arcadien/tars/hardware/design_notes.md

# TARS4 — design notes

Why each part is there and where it sits, plus the design rules behind the circuit. The circuit itself is the KiCad
schematic ([kicad/tars4.kicad_sch](kicad/tars4.kicad_sch), PDF [kicad/tars4_schematic.pdf](kicad/tars4_schematic.pdf)),
the boards are the plans generated by `tools/boards.py` (`renders/tars4_board_{s3,p1,p2,power}.svg`, checked against the
schematic), the GPIO assignment is the README's *Signals* table, the wiring is [tars4_wiring.html](tars4_wiring.html)
and the harness guide [tars4_harness.html](tars4_harness.html). Requirements: `requirements/`.

## Parts

| Ref | Part | Why / where |
|---|---|---|
| U1 | TP4056 + DW01 + FS8205A | 0.5 A charge: its R_PROG (1.2 k, "122") is replaced by 2.4 k ("242"); at 1 A it would dissipate 1–1.8 W in the closed leg. Cell protection. |
| BT1, BT2 | 18650, in parallel | same model, voltages equal within ±0.05 V before joining them; each cell comes through its XH connector (X12 left, X16 right), joined on the TP4056 B+ / B− pads |
| F1, F2 | PPTC 30 V, 1.6 A hold (~3.2 A trip), XF160 | on the + of each cell, right after the + plate; standing on the inner front wall in front of each cell (15 mm wide: too wide for the top shelf) |
| J1 | micro-USB breakout (`usbb` in the model) | the charge port, at the heel of the left leg; its VBUS / GND go to the TP4056 IN pads |
| D3 | TVS SMAJ5.0A / SMBJ5.0A, unidirectional | on the TP4056 IN+ / IN− pads, cathode on IN+: electrostatic discharges; does not protect against a lasting overvoltage |
| C9 | 22 µF 16 V electrolytic (10–47 µF), Ø ≤ 5.15 lying | with D3 on the TP4056 IN pads: damps the hot-plug overshoot at the end of the ~16 cm of wire from J1 |
| Q1 | AO3401A, logic-level P-MOSFET | power path: cells → VSYS, off on mains (gate on VUSB) |
| D1 | 1N5822, 3 A Schottky, through-hole | VUSB → VPATH on mains; band on the VPATH side, before the switch |
| R1 | 4.7 k | Q1 gate → GND: fast switch-over when unplugged (~50 ms); a warm D1 leaking 50 µA leaves the gate < 0.25 V |
| SW1 | slide switch, ≥ 1 A | after the merge point; rating to check (often only 0.3–0.5 A) |
| U9 | TPS63020 module, 3.3 V | buck-boost in the left leg, 3.3 V to the S3 3V3 pin; EN to VIN, PS/SYNC to GND (solder bridge, never high). Its own VSYS / GND pair from the star; the logic GND to P1 leaves from its GND pad, along its 3V3 wire |
| C1 | 220 µF 10 V polymer tantalum 7343 (Panasonic 10TPE220ML, ESR 25 mΩ), band = + | mandatory: 3V3 → GND as close as possible to the S3 3V pin, flat on the carrier under the S3, ~35 cm of wire from the TPS63020 |
| R15, R16 | 68 k + 100 k | on the power-path board: VUSB → USB_DET (GPIO21), ~3 V with the charger plugged in, 30 µA on USB only |
| R2, R3 | 1 M + 1 M | R2 in line in the harness at the TP4056 B+ pad (the sense wire carries B+ only behind 1 M), R3 on the power-path board: B+ / 2, the cell voltage even on mains (VSYS is then the USB rail, ~4.6 V); the VBAT/2 wire goes to GPIO1 (≈ 2 µA standing, C6 holds the reading) |
| Q4, R23, R24 | BC547B NPN + 1 M + 330 k (1/4 W) | VSYS sense (GPIO37, low = rail up, threshold 2.3–2.7 V, above the amplifier's 2.5 V minimum): R23 soldered in line in the harness at the power-path board end (the wire through the left tube only carries VSYS behind 1 M), then X14 → R24 base → GND and Q4 standing on the carrier, collector bridged to IO37 (internal pull-up only while reading), ~2–3 µA |
| C6 | 0.1 µF ceramic ("104"), never tantalum nor film | GPIO1 → GND at the S3: a tantalum's leakage would skew the reading by up to 0.5 V; film is too wide |
| C8 | 0.1 µF ceramic ("104") | GPIO21 → GND at the S3: USB_DET comes out of a ~40 k divider and runs along the amplifier pair in the left tube |
| C2, C3 | 10 µF 16 V tantalum (+ to 3V3) or X5R / X7R ceramic, + 0.1 µF ceramic | on P1, between the 3V3 and GND strips |
| R4 | 10 k | on P1, BL_EN → GND: backlights off at boot |
| R10 | 1 k | on P2, in series GPIO4 (AMP_SD) → amplifier SD |
| R18 | 10 k | on P2, amplifier SD → GND: the amplifier stays off at boot and in sleep despite its board's pull-up (SD < 0.16 V) |
| C7 | 470 µF 10 V low-ESR electrolytic, Panasonic EEUFC1A471, Ø8 × 11.5, − to GND | on the amplifier VIN / GND pins (module side of X5), lying behind the board |
| R11, R13, R14, R20 | 33 Ω | in series at the S3: microSD CLK, amplifier BCLK and LRC, screens MOSI |
| R12, R19 | 47 Ω (up to 100 Ω) | on the S3 carrier: split SCK, R12 → screen 1, R19 → screen 2 through its own wire |
| R5–R9 | 10 k | microSD pull-ups (CMD, D0–D3) to SD_3V3, if the reader has none |
| Q5, R22 | AO3401A + 100 k | on the power-path board: cuts the microSD 3V3 in sleep (GPIO36 SD_EN low = on; R22 gate → 3V3 keeps it off while the pin floats) |
| C4, C5 | 10 µF 16 V tantalum (+ to SD_3V3) + 0.1 µF ceramic | at the microSD reader (hot insertion) |
| R17 | 1 k | on P2, in series between the AM312 output and the PIR wire (GPIO3): limits the current if the pin is misconfigured |
| R21, C12 | 100 Ω + 10 µF 16 V tantalum (+ on PIR_VDD) | on P2 (fc 160 Hz, ~40 dB at 20 kHz): filters the AM312 supply against the backlight PWM ripple on the shared 3V3 |
| C10, C11 | 10 µF 16 V tantalum (+ to 3V3) + 0.1 µF ceramic | on P2, between the 3V3 and GND strips |
| U10 | AM312 PIR | top of the right middle column, dome flush in a Ø11.5 front hole (cap glued from the inside), 1.25 mm right of the axis to clear the middle tube; 2.7–12 V, ~15 µA, push-pull output held ~2 s, active high |
| U11 | BME280 (GY-BME280, 3.3 V) | right leg, the coolest spot, sensor against the wall facing a Ø1.5 vent; I2C 0x76 / 0x77; SDA / SCL / 3V3 / GND from P2 through the right tube |
| LS1 | speaker, 4–8 Ω | on OUT+ / OUT− (no ground); size not settled (branch `mech-audio`) |
| P1, P2 | stripboards 24 × 32 | distribution: P1 left middle under screen 1, P2 right middle under screen 2 |
| U2 socket | 2 female 2 × 8 headers on the 25.6 × 34.4 carrier (P3) | the S3 plugs in; all its wires are soldered on the back of the carrier |
| X1–X16 | keyed Dupont (X1–X9, X15), JST-XH (X10, X12, X13, X14, X16) | one connector between each module and the harness, nothing to re-solder to test or swap a module; list and keying in the wiring plan |
| (Q2, Q3) | AO3401A + AO3400A or 2N7002 + 10 k | probably not needed: BLK most likely drives an on-board transistor (a few mA). Only if the measurement shows BLK feeds the LEDs |

## Power and ground

- B− is not GND: the DW01 and its MOSFETs (FS8205A) sit between them. Everything else refers to OUT− (GND).
- Star ground on the power-path board (left leg): the TPS63020 and the amplifier each get their own VSYS / GND pair from
  it; the logic GND to P1 leaves from the TPS63020 GND pad and runs along its 3V3 wire (a single loop); the microSD
  gets its own GND from P1. Twisted pairs: B+ / B−, amplifier VSYS / GND, microSD CLK / GND.
- On mains, VUSB turns Q1 off (gate at 5 V) and feeds VSYS through D1 (≈ 4.7 V); the cells charge on their own. On
  battery, R1 pulls the gate to 0 V and Q1 conducts.
- Battery cut-off at 3.3 V read on B+ (GPIO1, under load): the TPS63020 holds 3.3 V down to ~2.5 V input, the cut-off
  only spares the cells.
- The S3 V pin (VBUS) only gets its own USB-C (its contact is removed from the carrier header): a PC's 5 V only feeds
  the S3 internal regulator (ME6211, 500 mA), never VSYS nor the cells. Flash with the switch on or off. On USB, the
  ME6211 and the TPS63020 feed the 3V3 together: the TPS63020 in power-save mode does not fight it. Never drive its
  PS/SYNC high: in forced PWM it can sink current and send the S3 regulator's current back to the cells. On battery, a
  little 3.3 V leaks back through the ME6211 to VBUS (to measure, cable plugged into a PC that is off).
- To check: the TPS63020 must not start from its output (VSYS < 2.5 V), the max input voltage of the unpowered MAX98357A.

## Signals

- BL_EN (GPIO7) only drives the backlights: PWM possible (LEDC, ~20 kHz). R4 holds it low at boot, `gpio_hold` in
  sleep. Not the S3 EN pad (that is its reset, next to GPIO1).
- AMP_SD (GPIO4): R10 in series and R18 to GND on P2, the amplifier stays off at boot and in sleep whatever is on BLK;
  high (> 1.4 V) = left channel. To check: the SD pull-up on the amplifier board (Adafruit: 1 M).
- Amplifier on I2S0 (BCLK, LRC, DIN), microphone on I2S1 with its own clocks (GPIO 14, 38, 15), wired locally: neither
  imposes a sample rate on the other.
- Screens: SPI at 26.7 MHz to start (35 ms per frame and screen), 40 MHz to try (ST7789 ~62 MHz max); SCK split on the
  carrier (R12 → screen 1, R19 → screen 2, its own wire), up to 100 Ω if the image jitters; screen 2's SCK next to its
  GND in the tube, away from BCLK; GPIO12 with reduced drive strength. Shared RST: `RST = -1` in the library, one reset.
- microSD: on a reader labelled for SPI, CLK = SCK, CMD = DI / MOSI, D0 = DO / MISO, D3 = CS (pull-up). SDMMC 1-bit
  10 MHz, R11 in series on CLK, C4 / C5 at the reader.
- I2C at 100 kHz with the glitch filter: ADXL345 0x53, BME280 0x76, DS3231 0x68 + its EEPROM 0x57. The boards'
  pull-ups add up (~1.6–2.4 k): fine at 100–400 kHz, remove one pair if needed. ADXL345: CS to 3V3 (I2C), SDO to GND.
- DS3231 ZS-042 with a CR2032: remove the cell charging resistor; SQW not wired (the S3 wakes on its own timer, the
  RTC keeps the time).
- Charger detection: USB_DET (GPIO21) high = cable in the charge port (display, no battery cut-off, wake on plug-in).
  End of charge is deduced from B+ (GPIO1) falling back from 4.2 to ~4.15 V while USB_DET stays high.

## Sleep and wake-up

- Wake-up: on the ESP32-S3, EXT1 takes one polarity only. Everything is active high: ADXL345 INT1, PIR (AM312) and
  USB_DET → EXT1 ANY_HIGH on GPIO 2, 3 and 21. Remove from the mask any source already high when going to sleep
  (GPIO21 on mains, GPIO3 while the PIR holds), otherwise the S3 wakes at once. Timed wake-up: the S3 timer. Clear the
  ADXL345 INT_SOURCE and wait for PIR low before sleeping.
- Aim at ~0.2–0.4 mA in sleep: remove the S3 RGB LED (GPIO47, 0.3–1 mA even off) and every status LED fed by the
  battery (ZS-042, TPS63020 module, GY-291, microSD reader), keep the TP4056 charge LEDs (USB only); disable the DS3231
  32 kHz output (register 0x0F bit 3); send SLPIN to the screens; `gpio_hold` on CS1 / CS2 / RST / BL_EN / AMP_SD; Q5
  cuts the microSD 3V3 (SD_EN high or floating).
- Deep discharge: after the 3.3 V cut-off ~5–10 % of capacity is left; the TPS63020 (25–50 µA), the R2 / R3 divider
  (2 µA), the SD card (0.1–0.5 mA), the RGB LED and above all the ZS-042 LED (1–3 mA) would drain it in 1–3 weeks.
  Store an "empty" flag in RTC memory (no wake-up until recharged).
- Firmware: ignore the cut-off if B+ < 2.5 V; keep BL_EN, AMP_SD and the amplifier I2S off until the supply is
  validated (VSYS sense on GPIO37, PLAT-POWER-VSENSE-001).
- Motion sensor uses: wake on approach, lock the PC (BLE keyboard) when leaving.
