arcadien/tars/references/51xlwRLxzuL._AC_SL1200_.jpg

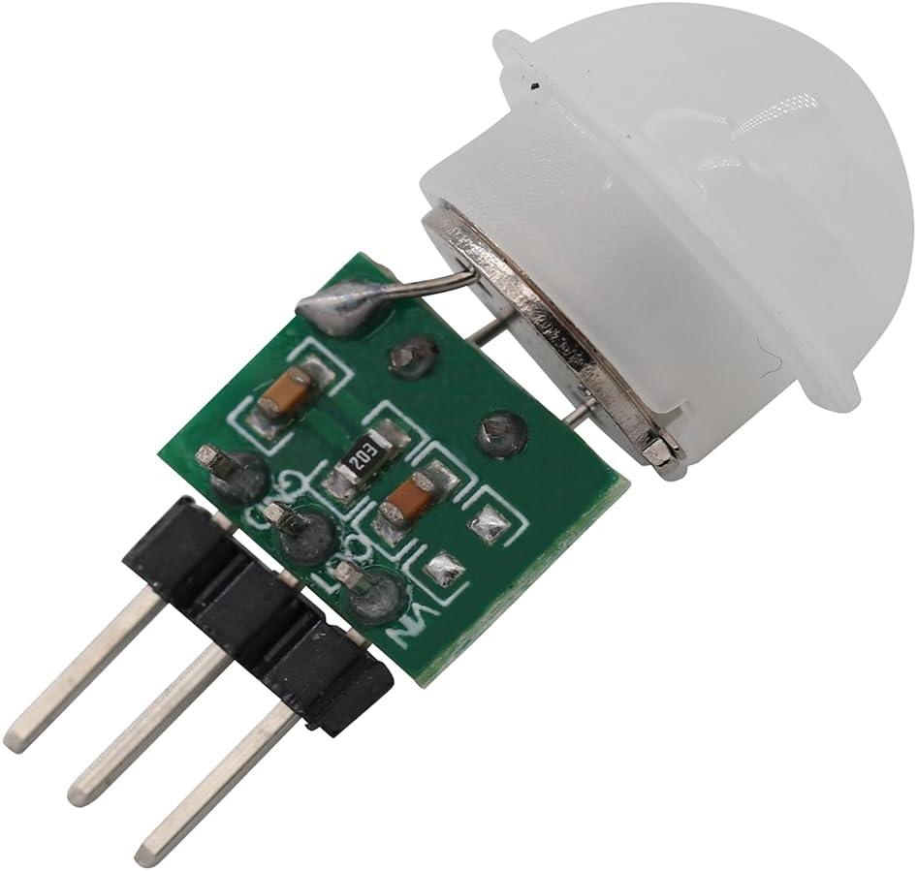
references/51xlwRLxzuL._AC_SL1200_.jpg
