arcadien/tars/references/ds3231_adxl345.jpg

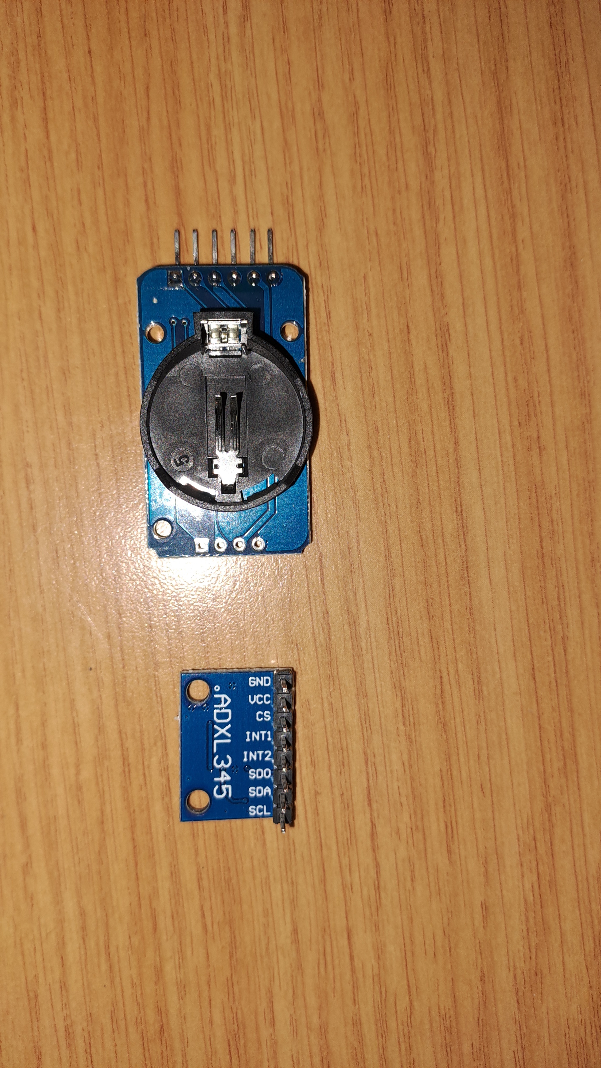
references/ds3231_adxl345.jpg
