arcadien/tars/references/esp32_s3_mini.png

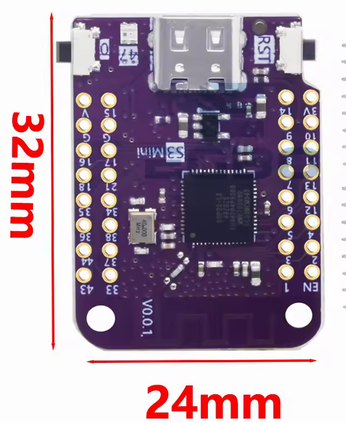
references/esp32_s3_mini.png
