arcadien/tars/references/film_still_tars.jpeg

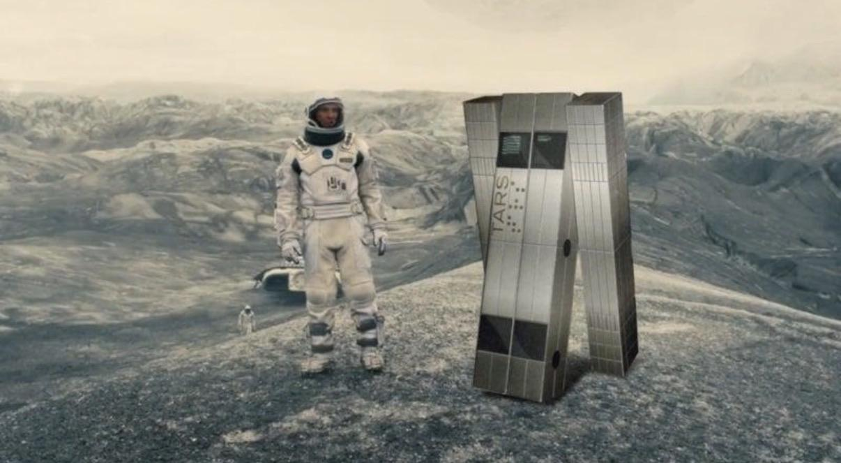
references/film_still_tars.jpeg
