arcadien/tars/references/film_still_torso_zoom.png

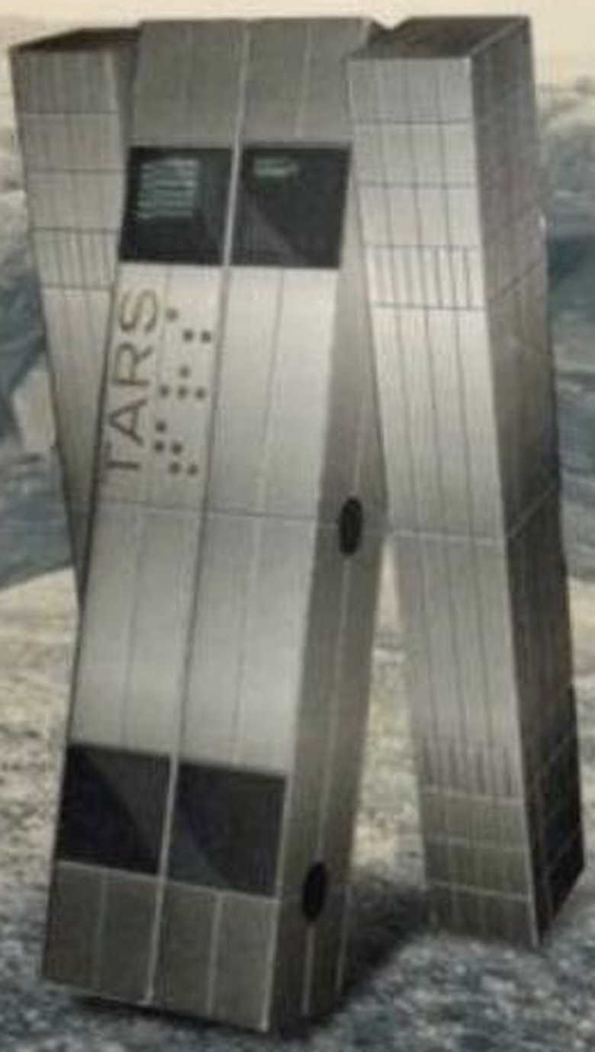
references/film_still_torso_zoom.png
