arcadien/tars/references/inmp441.png

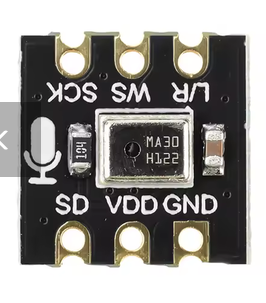
references/inmp441.png
