arcadien/tars/references/lcd_1.3_st7789_zjy-ips130.jpg

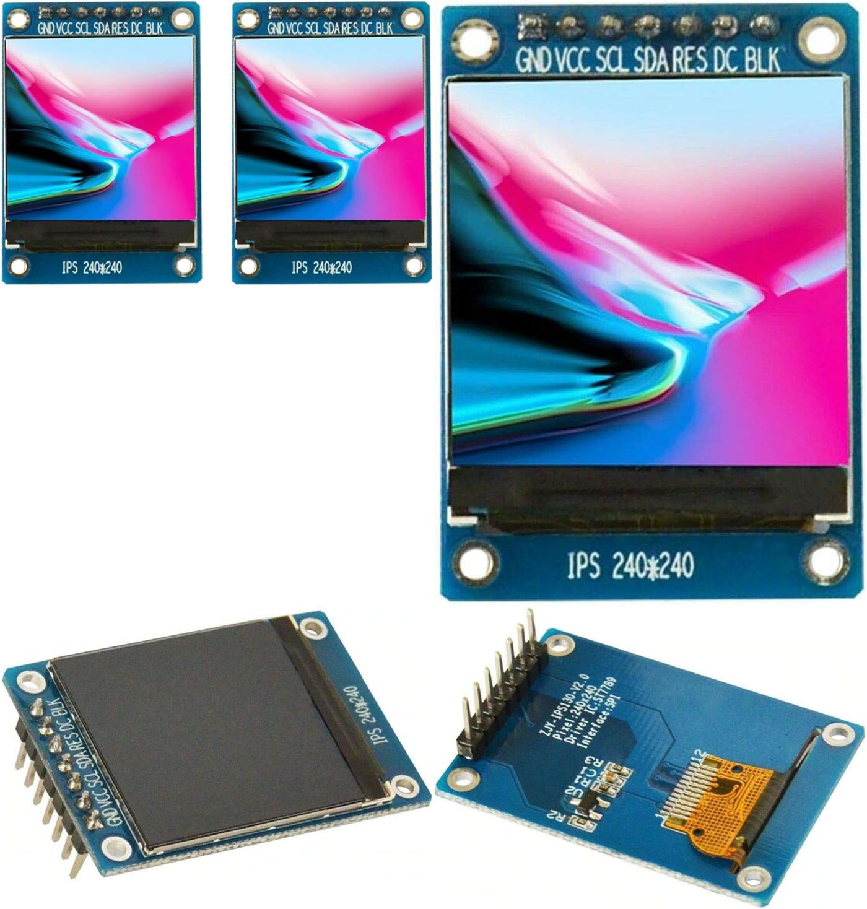
references/lcd_1.3_st7789_zjy-ips130.jpg
