arcadien/tars/references/s3_mini_dimensions.png

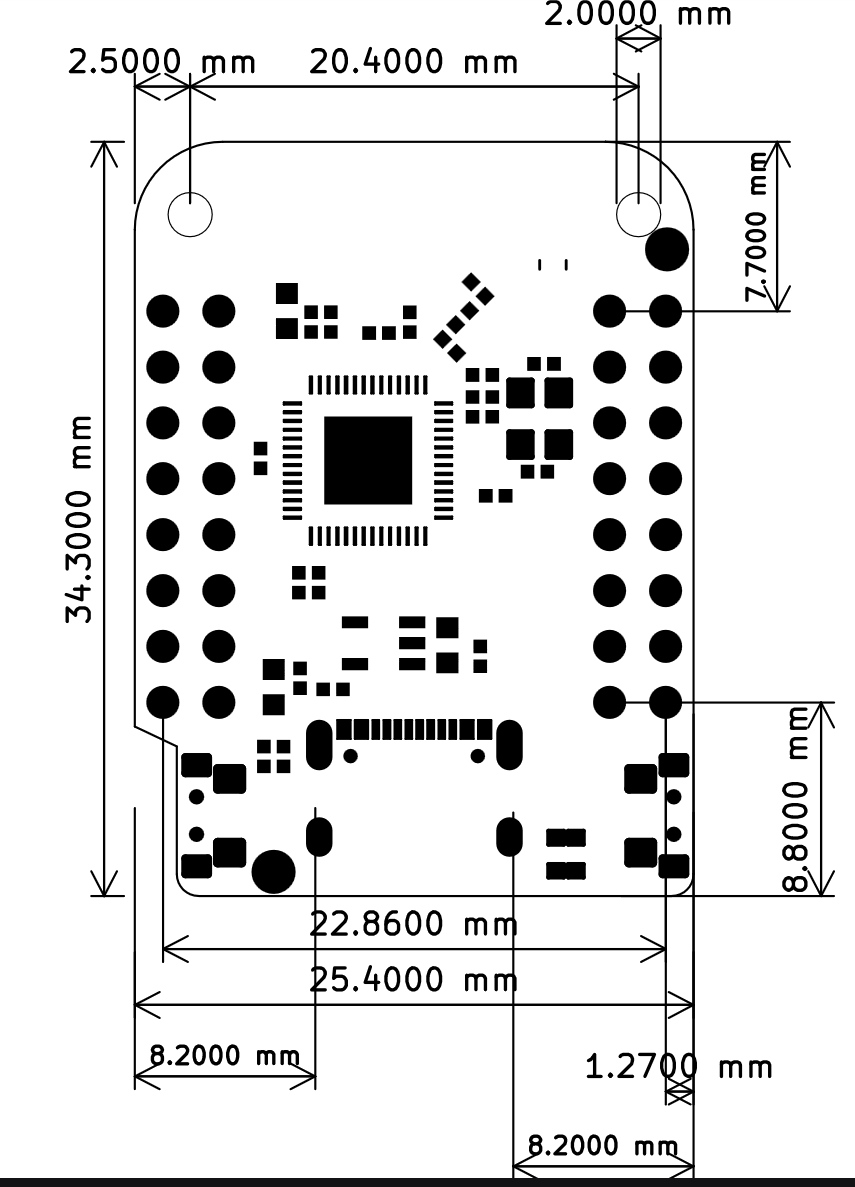
references/s3_mini_dimensions.png
