arcadien/tars/references/s3_mini_v1.0.0.jpg

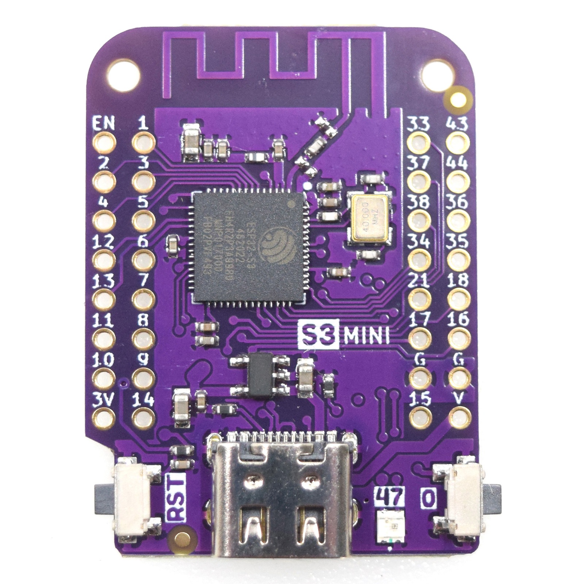
references/s3_mini_v1.0.0.jpg
