arcadien/tars/references/waveshare_lcd_0.85_drawing.jpg

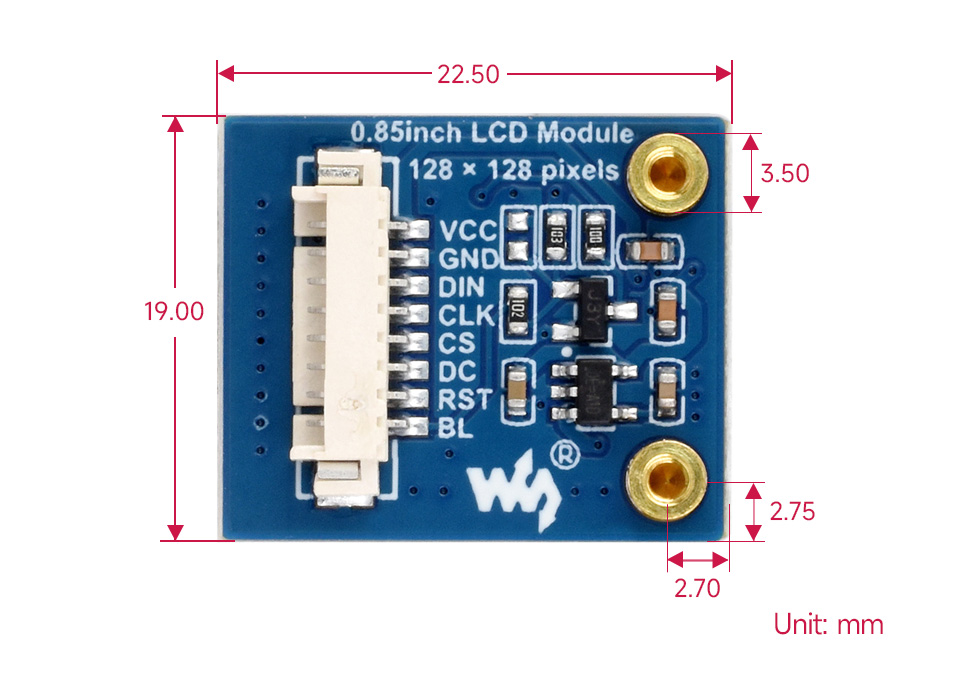
references/waveshare_lcd_0.85_drawing.jpg
