arcadien/tars/references/waveshare_lcd_1.69_drawing.jpg

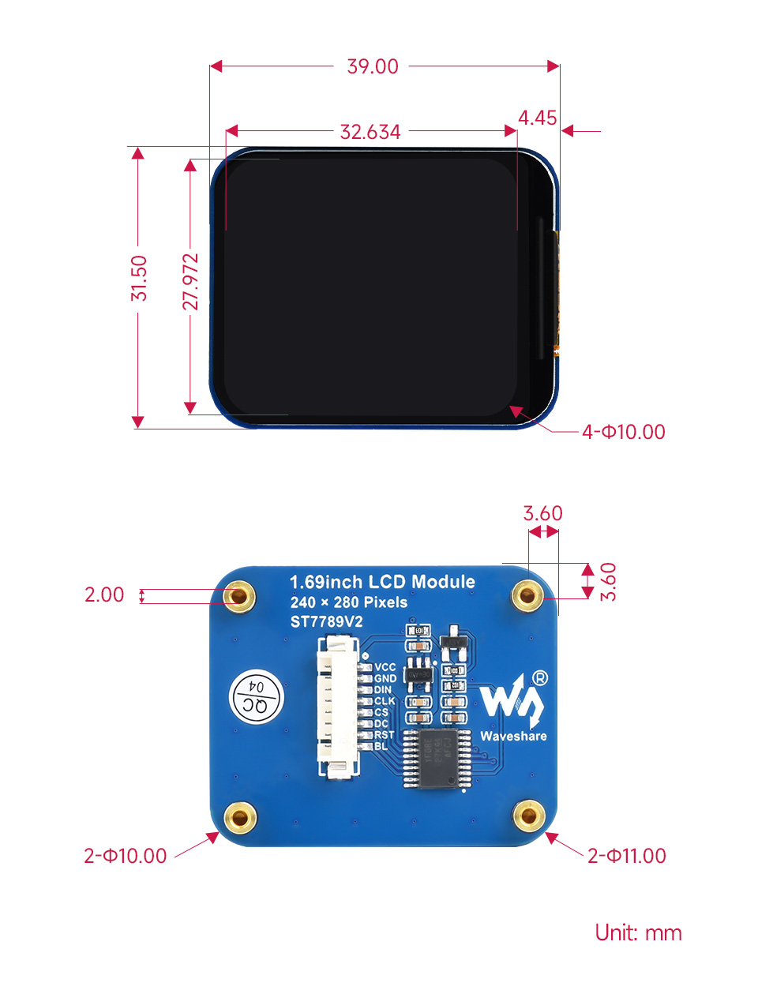
references/waveshare_lcd_1.69_drawing.jpg
