arcadien/tars/references/wiki_movement_modes.png

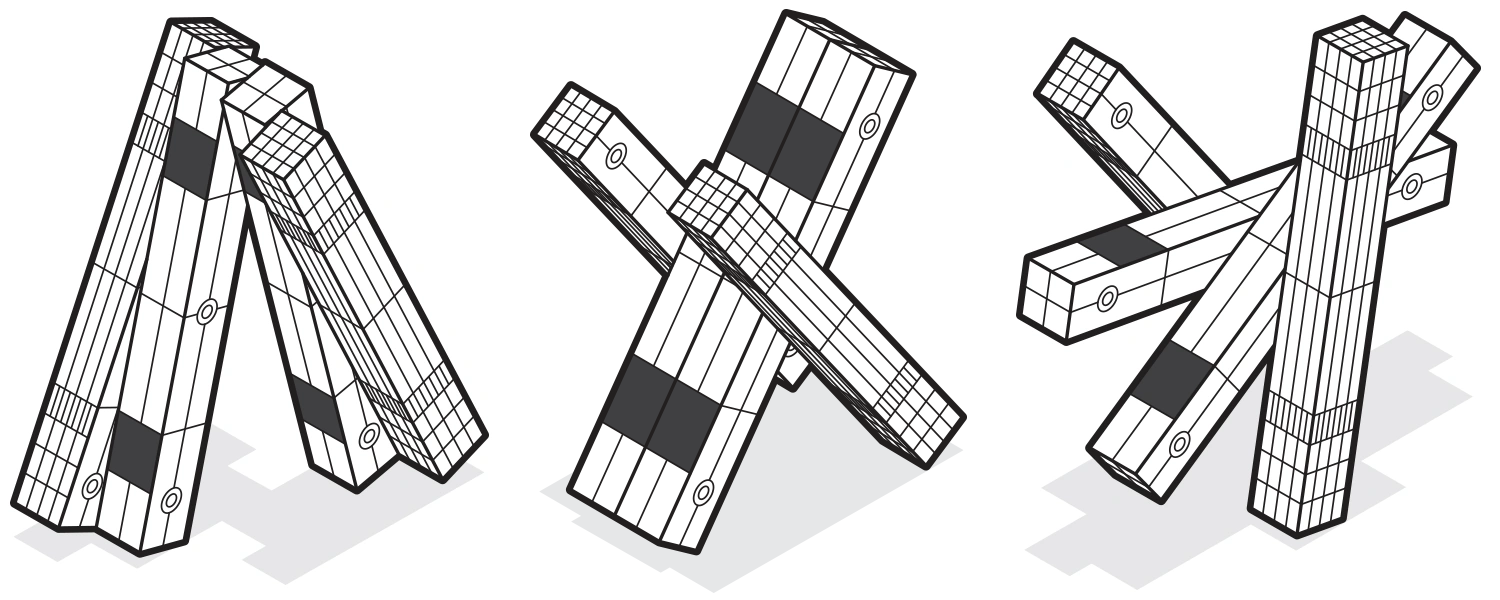
references/wiki_movement_modes.png
