arcadien/tars/renders/tars4_mid_column_inside.png

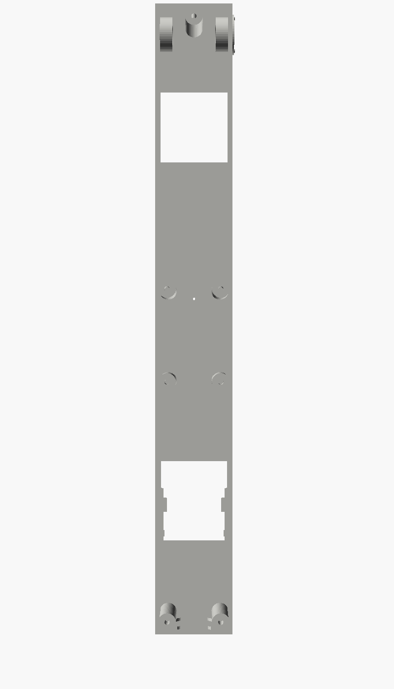
renders/tars4_mid_column_inside.png
