arcadien/tars/mechanical/3mf/tars4.3mf

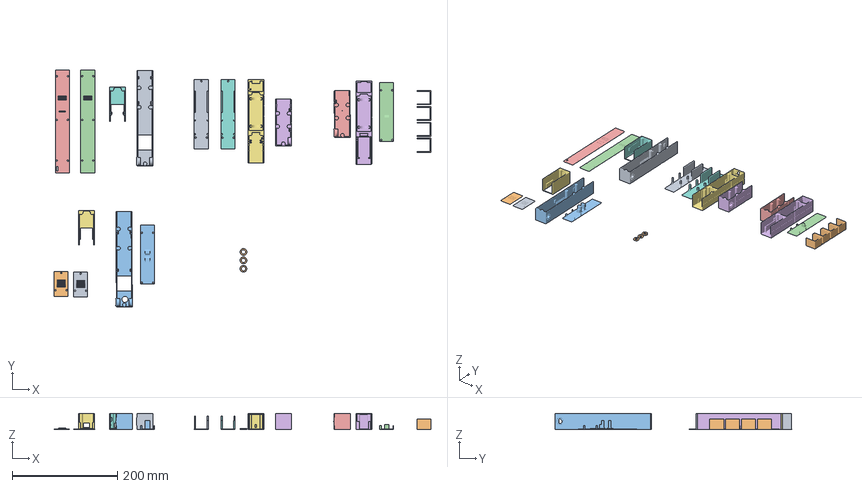
[picture p31: CAD file, 2026-10-29]
mechanical/3mf/tars4.3mf
716.6 x 451.4 x 31.0 mm
mid_left_top
tube_collars
mid_right_top
lid_leg_right_bottom
lid_leg_left_bottom
leg_right_bottom
leg_left_bottom
lid_mid_left_top
lid_mid_right_top
splints
lid_mid_right_bottom
lid_mid_left_bottom
leg_right_top
leg_left_top
mid_right_bottom
mid_left_bottom
lid_leg_left_top
lid_leg_right_top
