arcadien/tars/physical/stl/tars4_cr10_lid_leg.stl

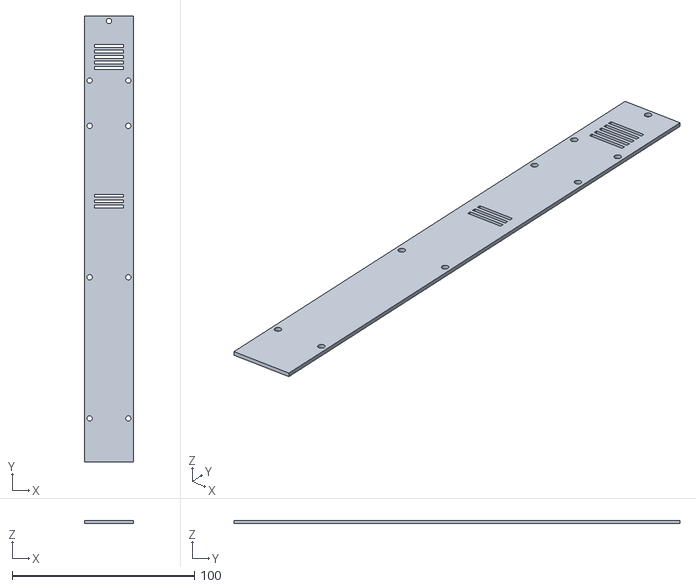
[picture p32: CAD file, 2026-10-28]
physical/stl/tars4_cr10_lid_leg.stl
26.8 x 244.4 x 1.60
