arcadien/tars/mechanical/3mf/tars4_cr10.3mf

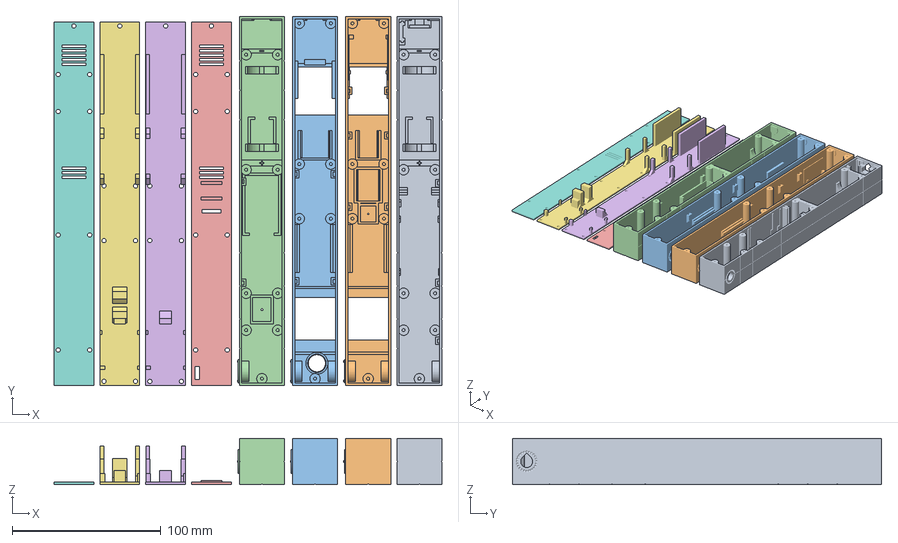
[picture p33: CAD file, 2026-10-29]
mechanical/3mf/tars4_cr10.3mf
260.7 x 248.0 x 31.0 mm
cr10_leg_left
cr10_mid_left
cr10_mid_right
cr10_leg_right
cr10_lid_leg_left
cr10_lid_mid_left
cr10_lid_mid_right
cr10_lid_leg_right
