arcadien/tars/physical/stl/tars4_col0_top.stl

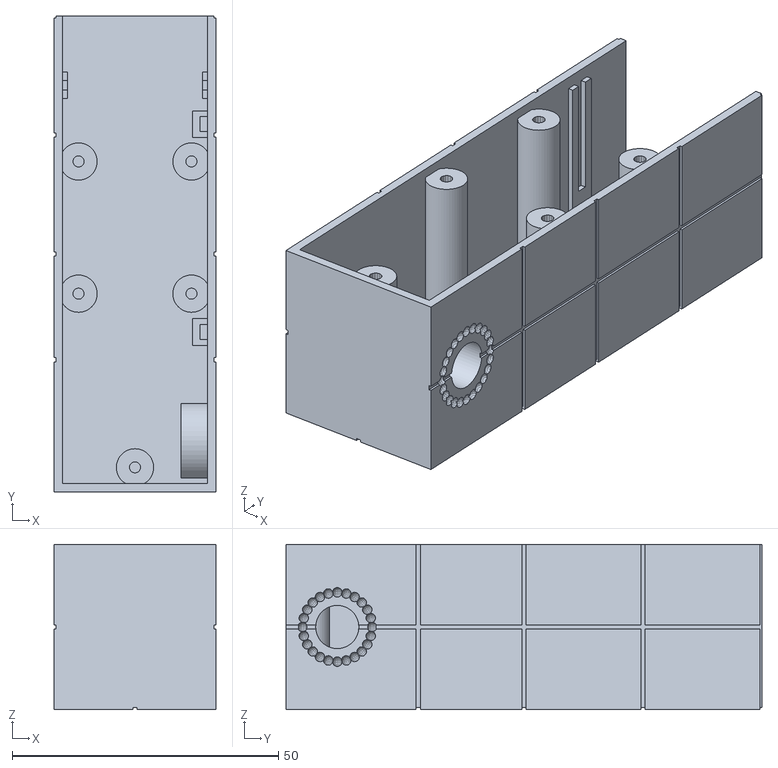
[picture p34: CAD file, 2026-10-28]
physical/stl/tars4_col0_top.stl
30.4 x 89.3 x 31.0
