arcadien/tars/physical/stl/tars4_tube_test.stl

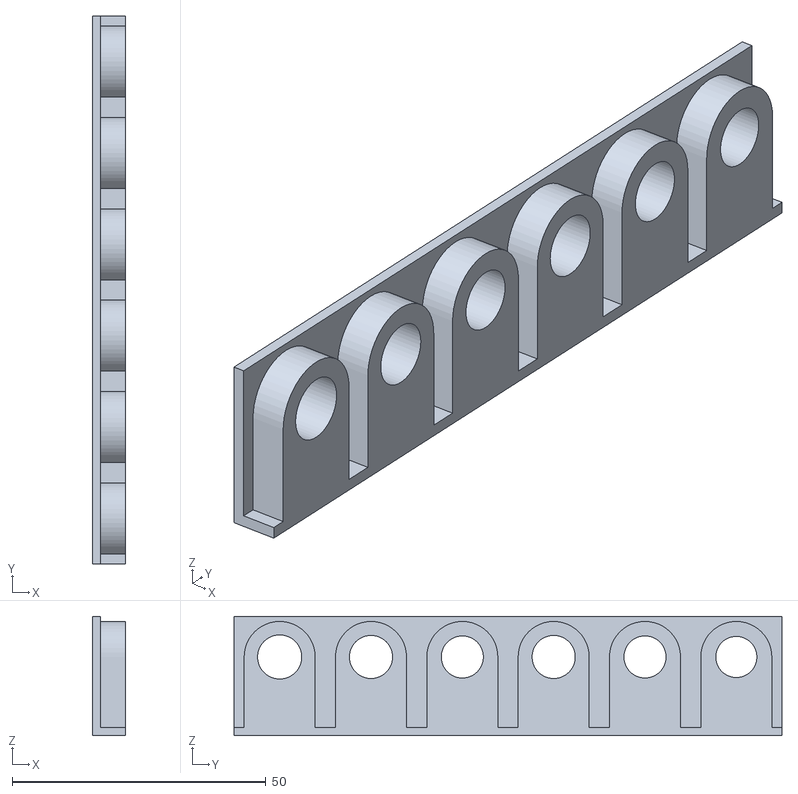
[picture p35: CAD file, 2026-10-28]
physical/stl/tars4_tube_test.stl
6.60 x 108.0 x 23.5
