arcadien/tars/physical/stl/tars4_cr10_col2.stl

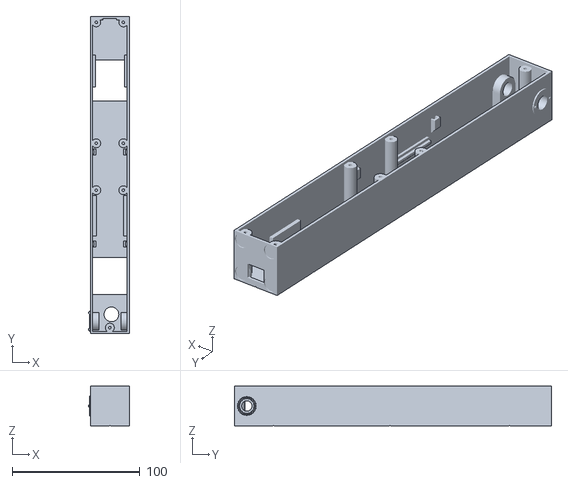
[picture p36: CAD file, 2026-10-28]
physical/stl/tars4_cr10_col2.stl
31.7 x 248.0 x 31.0
