arcadien/tars/physical/stl/tars4_lid_mid_top.stl

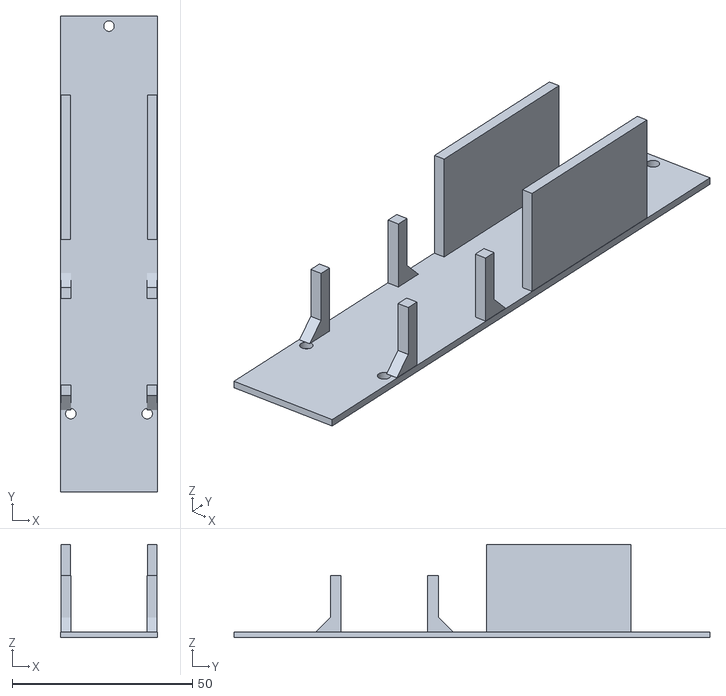
[picture p37: CAD file, 2026-10-28]
physical/stl/tars4_lid_mid_top.stl
26.8 x 132.0 x 25.9
