arcadien/tars/physical/stl/tars4_col2_bottom.stl

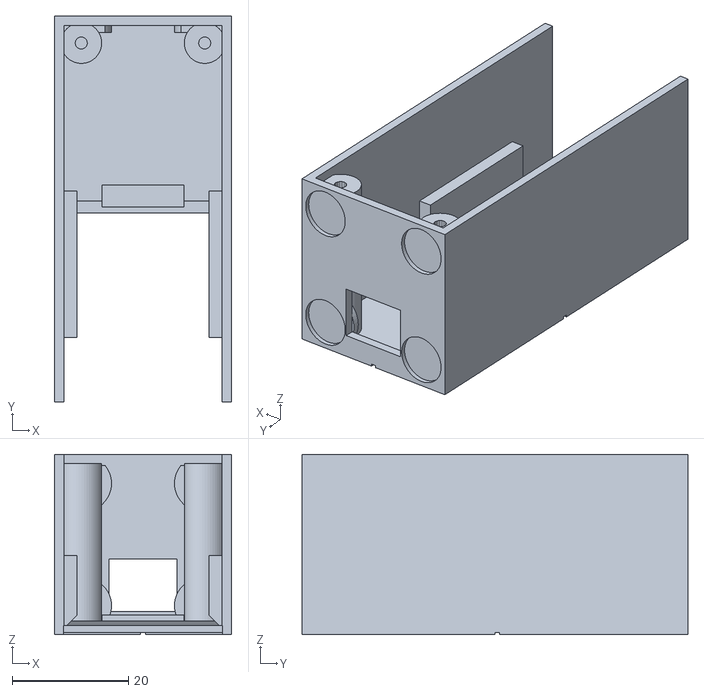
[picture p39: CAD file, 2026-10-28]
physical/stl/tars4_col2_bottom.stl
30.4 x 66.2 x 31.0
