arcadien/tars/physical/stl/tars4_col3_bottom.stl

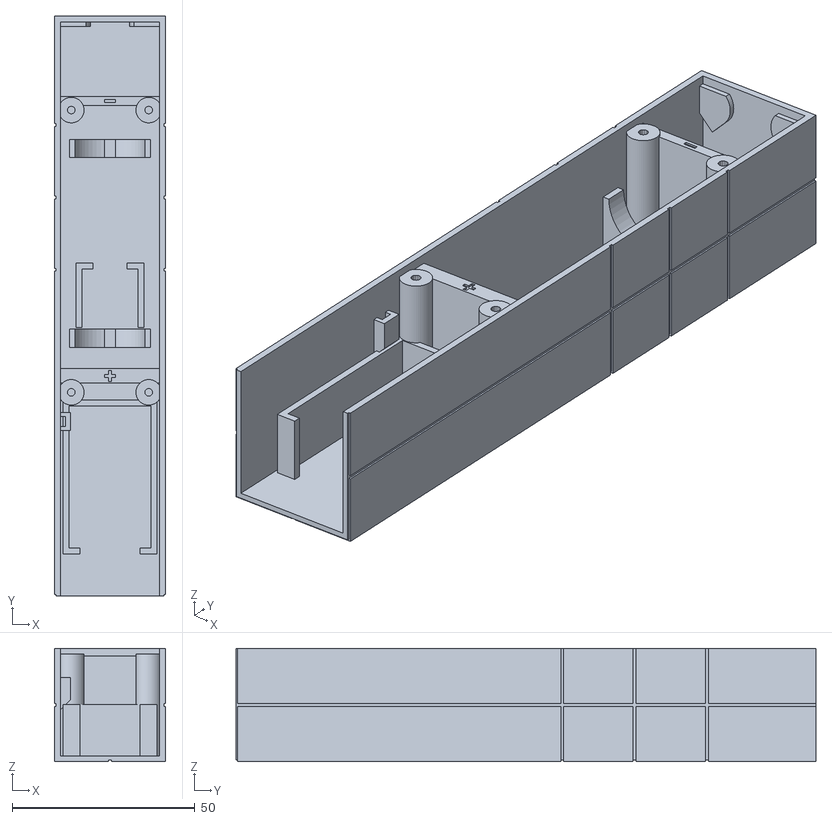
[picture p40: CAD file, 2026-10-28]
physical/stl/tars4_col3_bottom.stl
30.4 x 158.7 x 31.0
