arcadien/tars/physical/stl/tars4_pir_test.stl

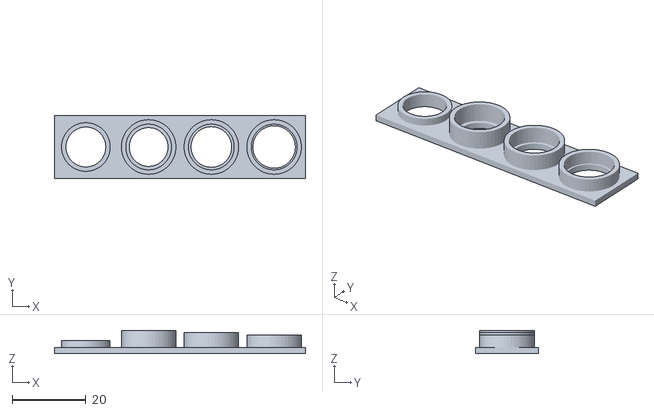
[picture p41: CAD file, 2026-10-28]
physical/stl/tars4_pir_test.stl
68.0 x 17.0 x 6.23
