arcadien/tars/physical/stl/tars4_col3_top.stl

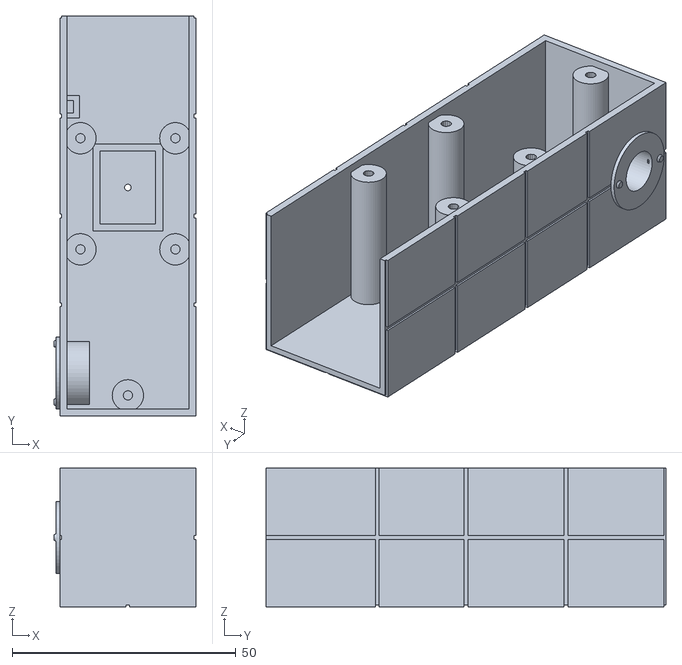
[picture p42: CAD file, 2026-10-28]
physical/stl/tars4_col3_top.stl
31.7 x 89.3 x 31.0
