arcadien/tars/physical/stl/tars4_cr10_col3.stl

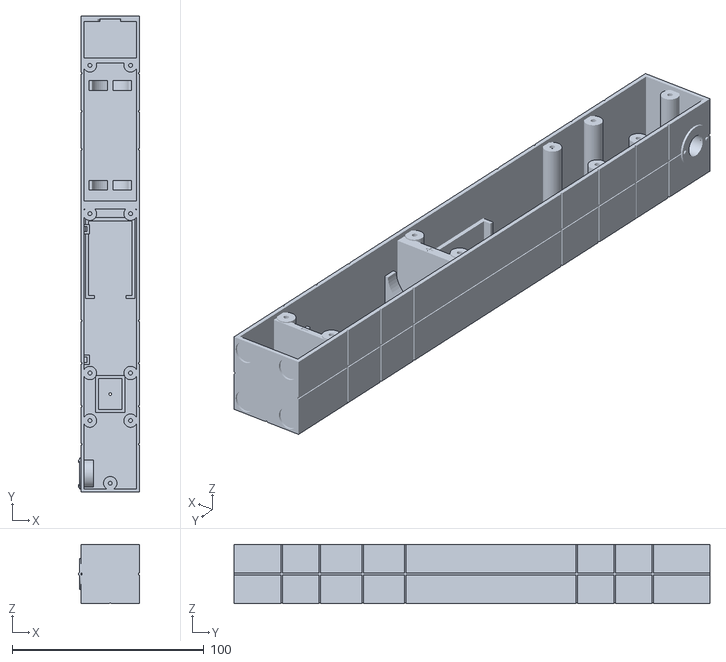
[picture p43: CAD file, 2026-10-28]
physical/stl/tars4_cr10_col3.stl
31.7 x 248.0 x 31.0
