arcadien/tars/physical/stl/tars4_lid_leg_sd_bottom.stl

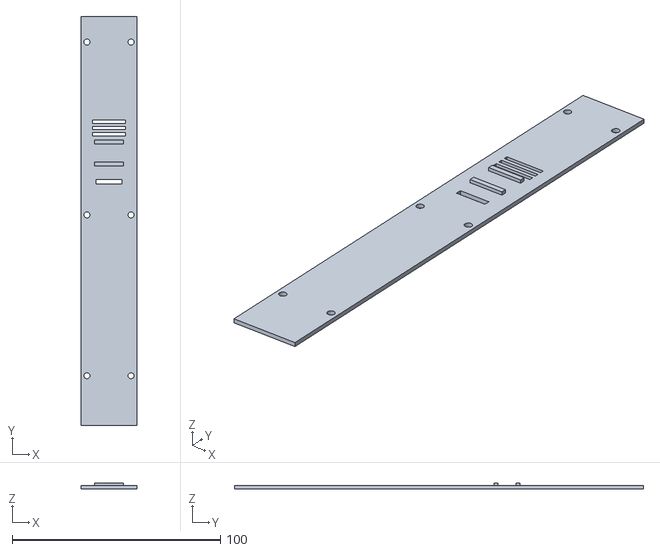
[picture p44: CAD file, 2026-10-28]
physical/stl/tars4_lid_leg_sd_bottom.stl
26.8 x 196.5 x 2.90
