arcadien/tars/physical/stl/tars4_cr10_lid_mid_left.stl

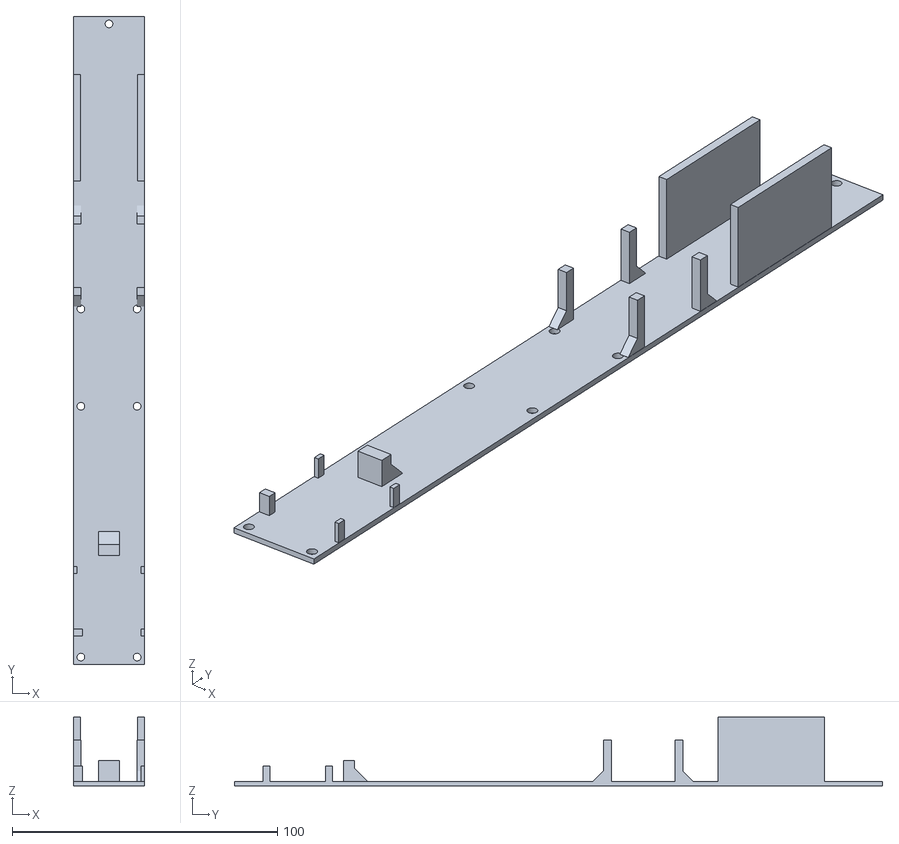
[picture p45: CAD file, 2026-10-28]
physical/stl/tars4_cr10_lid_mid_left.stl
26.8 x 244.4 x 25.9
