arcadien/tars/physical/stl/tars4_cr10_lid_leg_sd.stl

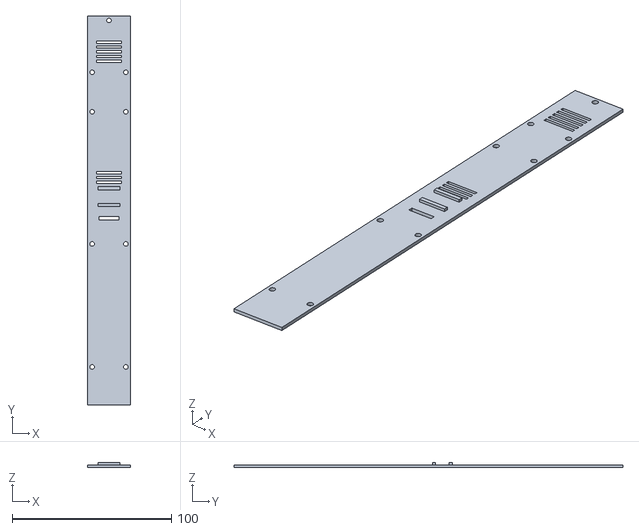
[picture p46: CAD file, 2026-10-28]
physical/stl/tars4_cr10_lid_leg_sd.stl
26.8 x 244.4 x 2.90
