arcadien/tars/physical/stl/tars4_lid_leg_top.stl

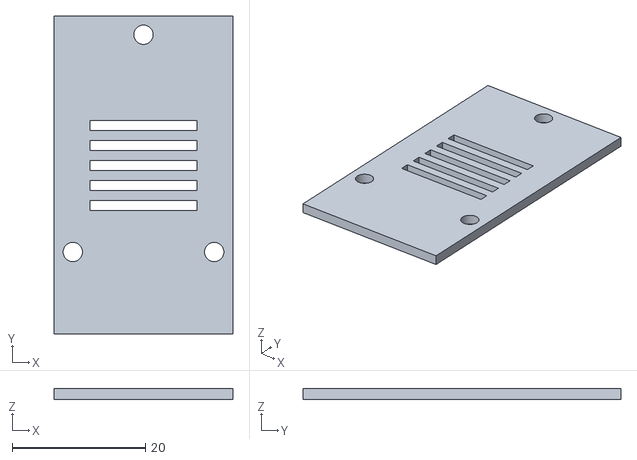
[picture p49: CAD file, 2026-10-28]
physical/stl/tars4_lid_leg_top.stl
26.8 x 47.7 x 1.60
