arcadien/tars/physical/stl/tars4_cr10_col0.stl

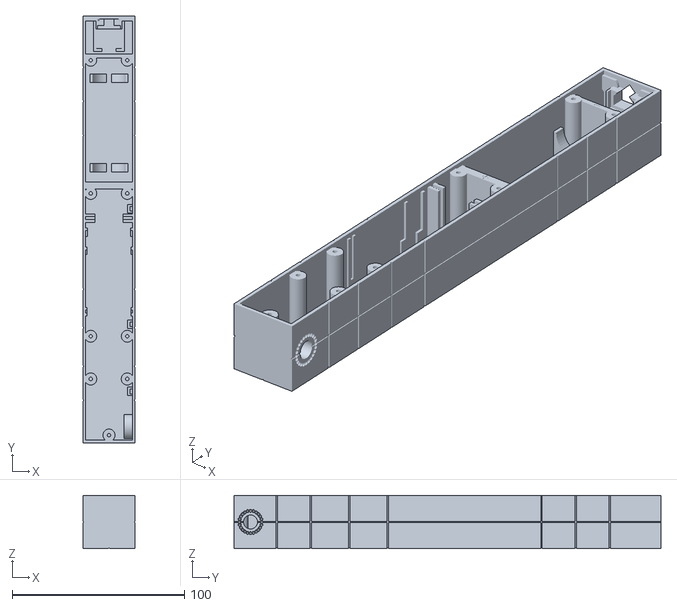
[picture p50: CAD file, 2026-10-28]
physical/stl/tars4_cr10_col0.stl
30.4 x 248.0 x 31.0
