arcadien/tars/physical/stl/tars4_cr10_col1.stl

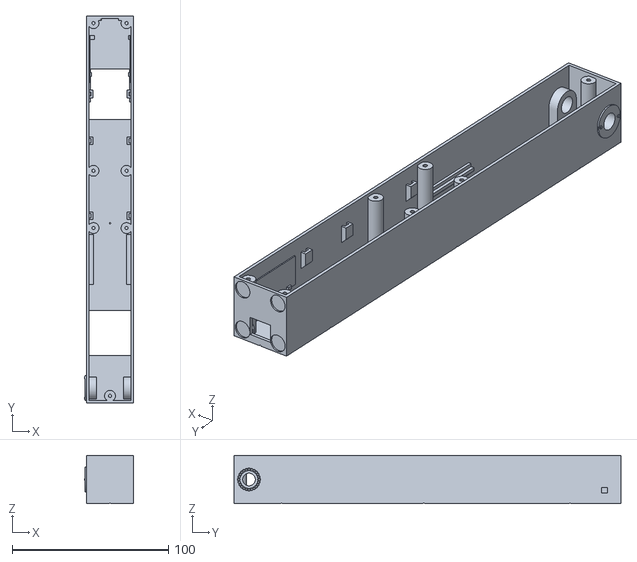
[picture p51: CAD file, 2026-10-28]
physical/stl/tars4_cr10_col1.stl
31.7 x 248.0 x 31.0
