arcadien/tars/physical/stl/tars4_lid_mid_bottom.stl

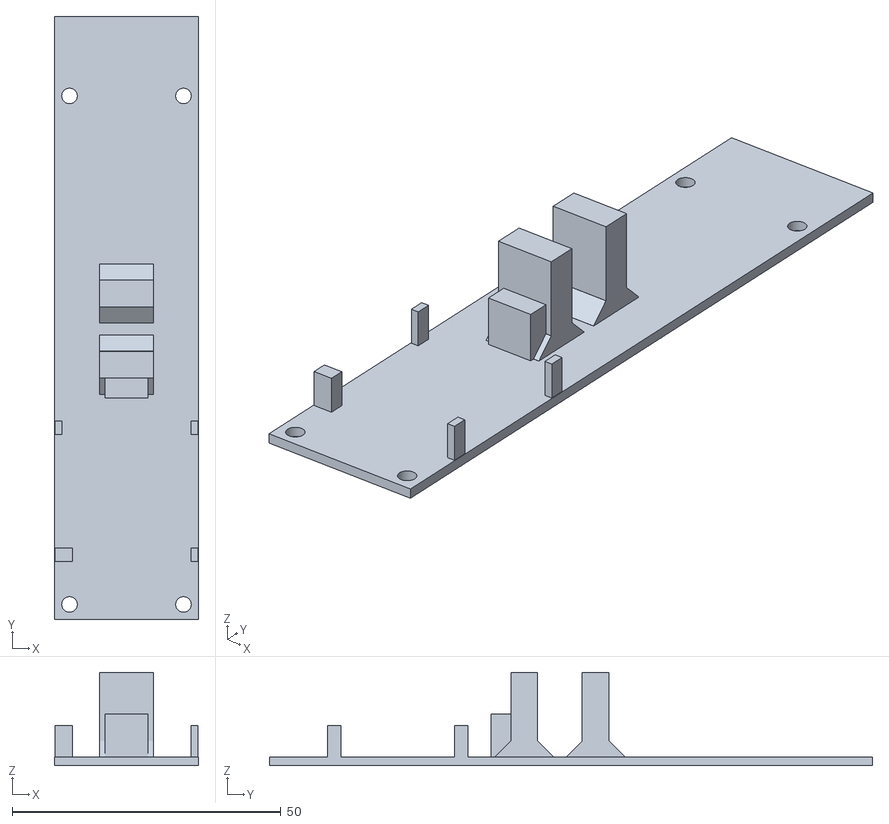
[picture p52: CAD file, 2026-10-28]
physical/stl/tars4_lid_mid_bottom.stl
26.8 x 112.2 x 17.4
