arcadien/tars/physical/stl/tars4_tube_test2.stl

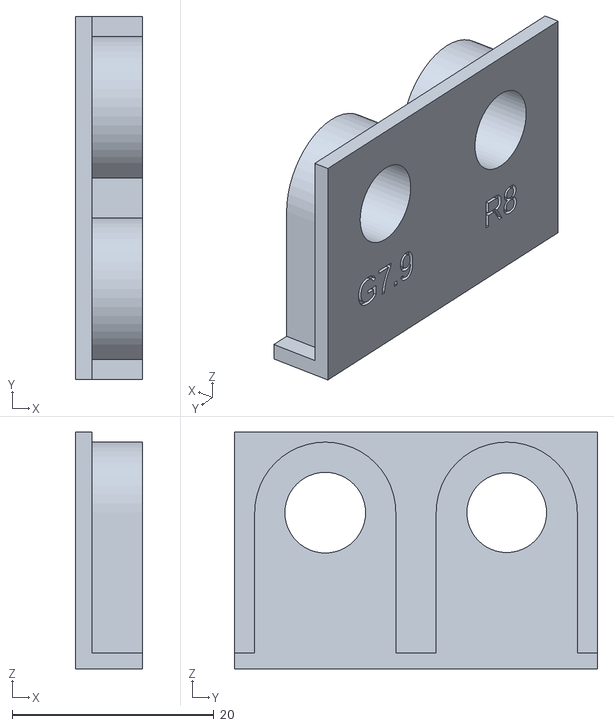
[picture p53: CAD file, 2026-10-28]
physical/stl/tars4_tube_test2.stl
6.60 x 36.0 x 23.5
