arcadien/tars/physical/stl/tars4_col2_top.stl

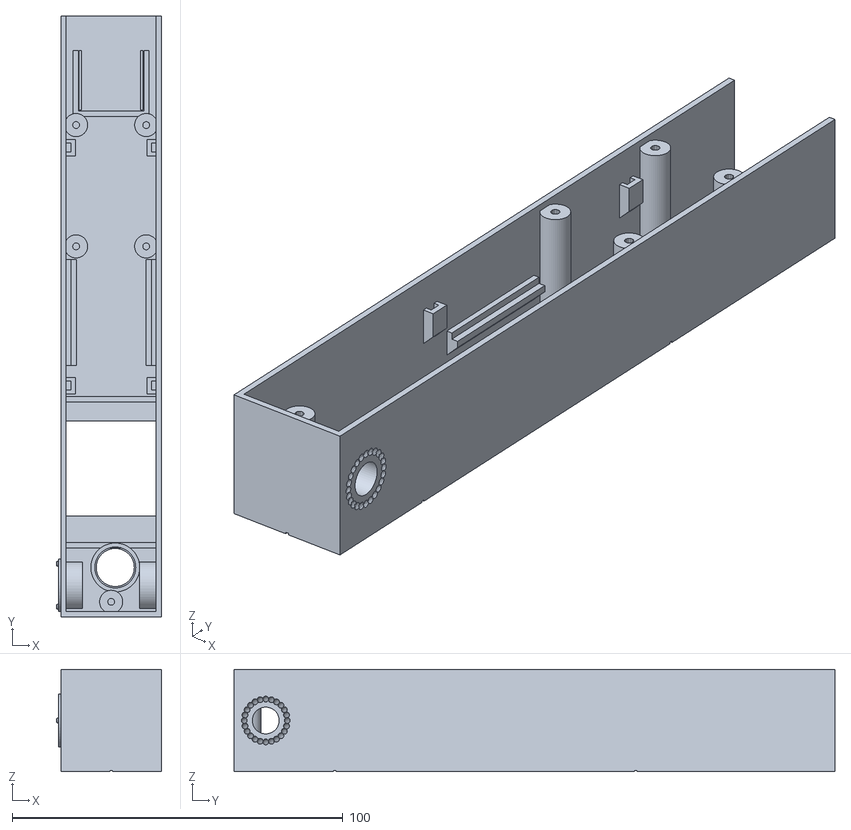
[picture p54: CAD file, 2026-10-28]
physical/stl/tars4_col2_top.stl
31.7 x 181.8 x 31.0
