arcadien/tars/(list of files, cad)

Other CAD files:
physical/stl/tars4_col1_bottom.stl
physical/stl/tars4_lid_mid_left_top.stl
physical/stl/tars4_tube_test3.stl
