arcadien/tars/hardware/tars4_wiring.html

# TARS4 — wiring, back view

TARS lying on its belly, lids removed. Seen from the back, the left leg is on the right of the drawing. Dimensions in mm, to scale; wires are schematic (they run behind the boards, on the lid side).

## Wires: actual kit colours

Power in pairs: red / black for the battery and 5 V (B+/B−, VUSB, VPATH, VSYS and their GND; each rail carries a coloured band at both ends, on the + and on its GND: none = B+ / B−, white = OUT+, yellow = VPATH, orange = VSYS, purple = VUSB), white / blue for the regulated 3V3 and its logic GND; blue is only used for that GND, never for a signal. 30 AWG, 10-colour kit: one colour per signal role, the same on every segment; heat-shrink rings at both ends (strokes across on the drawing) tell the buses apart: none = screens / measurements, 1 = I2S (amplifier and mic) and PIR, 2 = I2C, 3 = microSD. The coloured cable ties of the kit can replace the rings at the ends, never closer than 25–30 mm to a tube end. 26 AWG for power (thick strokes).

- white (3V3)all the 3V3, as in industry: 30 AWG for the screens and sensors, 26 AWG from the TPS63020 → P1 → S3; always paired with a blue
- black (26 AWG)pack B−; GND of the red rails, with the same coloured band as their +
- yellow (clocks)SCK · BCLK, MIC_BCLK (1) · SCL (2) · SD_CLK (3)
- green (data)MOSI · DIN, MIC_SD (1) · SDA (2) · SD_D0 (3)
- blue (regulated GND)26 AWG: logic GND TPS63020 → P1 → S3 · 30 AWG: GND of the screens and sensors, microSD GND (3 rings, twisted with CLK)
- red30 AWG (status): DC, INT1 · PIR, AM312 output (1) · 26 AWG: battery / 5 V rails, one coloured band per rail: none = pack B+, white = TP4056 OUT+, yellow = VPATH, orange = VSYS (star, TPS63020, amplifier), purple = VUSB
- orangeRST, USB_DET
- brownBL_EN, VBAT/2 · AMP_SD, VSENSE_B (1) · SD_EN (3)
- purple (select / frame)CS1, CS2 · LRC, MIC_WS (1) · SD_CMD (3)
- grey (26 AWG)speaker wires, + marked with a pen

## Nets

- Pack B+ / B−2 × 18650 in parallel, twisted pair, right cell → charger through the 3 tubes
- +VSYS / GNDcells (TP4056 OUT+ via AO3401A) or mains (micro-USB socket in the foot via D1 1N5822) → floor switch → star on the power-path board (z ≈ 171) → TPS63020 (3.3 V); dedicated twisted VSYS/GND pair → amplifier VIN. GND = TP4056 OUT− (≠ B−, the DW01 sits between them)
- 3V3 / logic GNDTPS63020 output (left leg) → P1 → S3 3V3 pin (26 AWG white / blue); screens, RTC, accelerometer, mic, sensors in 30 AWG white / blue; microSD locally
- Screen SPI ×5SCK, MOSI, DC, CS, RST per screen; SCK split on the S3 carrier (R12 → screen 1, R19 → screen 2, 47 Ω), no T on P1
- I2S ×3 (1 ring)I2S0: BCLK, LRC, DIN → amplifier (middle tube); I2S1: SCK, WS, SD ← mic, local (mic L/R to GND)
- I2C ×2 (2 rings)daisy chain: S3 → ADXL345 (0x53) → middle tube → P2 → right tube → BME280 (0x76) and DS3231 (0x68, EEPROM 0x57) in the right leg; pull-ups already on the boards; SQW not wired
- microSD ×3 (3 rings)SDMMC 1-bit: CLK (33 Ω at the S3), CMD, D0 → reader in the left leg, + 3V3 cut in sleep by Q5 (SD_EN, GPIO36) and a dedicated GND from P1 (twisted with CLK); 10 k pull-ups (to the switched 3V3) on CMD, D0, D1, D2, D3 if the reader has none; 10 µF + 100 nF at the reader; 10 MHz
- BL_EN · AMP_SDGPIO7 → BLK of both screens (backlight, PWM possible); GPIO4 → R10 1 k + R18 10 k on P2 → amplifier SD (off at boot and in sleep). Not the S3 EN pad (reset)
- Motion sensorAM312 behind a Ø10 hole in the front (top of the right middle, z ≈ 233), 1.25 mm right of the column axis; R17 1 k on P2 (under screen 2), 3 wires to the sensor; PIR (active high, red 1 ring) goes back through the middle tube to GPIO3
- VBAT/2 (brown) · USB_DET (orange) · VSENSE_B (brown, 1 ring)dividers on the power-path board → GPIO1 / GPIO21, through the left tube; VSYS through R23 1 M (in line at the board) → Q4 on the carrier → GPIO37
- Weather sensorBME280 (I2C 0x76) in the right leg, the coolest spot (z ≈ 190), sensor facing a Ø1.5 vent in the front; SDA / SCL / 3V3 / GND from P2 through the right tube, with the DS3231 (z ≈ 107)

## Boards (colour = bus)

- PowerTP4056 (+ D3, C9), power path, F1 / F2, TPS63020
- BrainLOLIN S3 Mini
- SPIscreens 1 and 2 (green frame)
- I2CDS3231, ADXL345, BME280
- I2S0MAX98357A (amplifier)
- I2S1INMP441 (micro)
- SDMMCmicroSD reader
- GPIOAM312 (R17 on P2)
- Distributionboards P1 / P2
- Speaker

## Wires per tube (8 / 7 mm, silicone wire: power 26 AWG Ø1.5, signals and screen / sensor supply in 30 AWG Ø0.8)

Joint | Wires | Content
left leg ↔ left middle | 14 | B+, B−, VBAT/2 (→ GPIO1), USB_DET (→ GPIO21), SD_EN (GPIO36 → Q5), VSENSE_B (VSYS through R23 → Q4 → GPIO37), logic GND and 3V3 from the TPS63020 (→ P1), amplifier VSYS + GND, microSD: CLK, CMD, D0, GND · ~37 %
left middle ↔ right middle | 19 | B+, B−, amplifier VSYS + GND, screen 2: SPI ×5 (SCK straight from R19 on the carrier), 3V3, GND, BL_EN, AMP_SD, I2S ×3, PIR (motion sensor), SDA / SCL (to the right leg) · Ø7 bore ~38 % full (4 × 26 + 15 × 30 AWG). Two GNDs: the amplifier one (VSYS/GND pair, straight back to the star) and the logic GND of screen 2 (from P1)
right middle ↔ right leg | 6 | B+, B−, SDA, SCL, 3V3, GND (DS3231 + BME280) · ~14 %

## Connectors (everything comes apart: bench test first, no soldering to redo)

Ref. | Module ↔ harness | Type · keying | Where (z in mm)
socket | LOLIN S3 Mini ↔ its carrier | 2 female 2 × 8 headers | left middle, 8–43: S3 + carrier come out from the back on their wire loop, then the S3 is unplugged
X1 | screen 1 | Dupont 1 × 8 on a right-angle header on the back, pins down · 1 mm rib glued on the lid-side face of the housing | left middle, flat on the back of the screen, 205–223
X2 | ADXL345 | Dupont 1 × 8 (5 wires) · INT2 pin removed, cavity plugged | left middle, left edge, 103–124
X3 | INMP441 | pigtail + inline Dupont 1 × 6 (5 wires) · 6th cavity plugged on the female side, empty on the male side | left middle, against the lid, 103–131
X4 | screen 2 | as X1 | right middle, 205–223
X5 | MAX98357A | two housings: 1 × 4 (LRC, BCLK, DIN, GAIN removed and plugged) + 1 × 3 (SD, GND, VIN; reversed: SD and VIN swap through R10, no damage) | right middle, top edge of the amplifier, ~93
X6 | speaker | Dupont 1 × 2 (header instead of the screw terminal) | right middle, bottom edge of the amplifier, ~78
X7 | AM312 | pigtail + inline Dupont 1 × 4 (3 wires) · empty cavity plugged | right middle, against the lid next to the screen, 191–225
X8 | DS3231 | Dupont 1 × 6 on its right-angle pins (4 wires) · 32K pin removed, cavity plugged | right leg, above the board, 145–166
X9 | BME280 | Dupont 1 × 4 on its pins · unkeyed: reversed, nothing breaks (I2C bus stuck) | right leg, top edge, ~204
X10 | J1 + SW1 ↔ power block (VUSB, GND, VPATH, VSYS) | inline JST-XH 4 (keyed): the charge port cable and the switch cable in one housing | left leg, parked above the TP4056, front row, 144–166
X12 | left cell ↔ power block | inline JST-XH 2 (female on the cell side) | left leg, above the TP4056, 144–166
X16 | right cell ↔ power block (through the 3 tubes) | inline JST-XH 2 (female on the cell side); both cells joined on the TP4056 B+ / B− pads | left leg, above the power-path board, 180–202
X13 | power block ↔ tubes (amplifier VSYS / GND, 3V3, logic GND) | inline JST-XH 4 | left leg, above the TP4056, 144–166
X14 | power block ↔ tubes (VBAT/2, USB_DET, SD_EN, VSENSE_B) | inline JST-XH 4 | left leg, above the TP4056, its own row in front of X10, 144–166
X15 | microSD reader | pigtail + inline Dupont 1 × 6 (5 wires) · empty cavity plugged | left leg, front corridor, 107–141

The harness is soldered once (P1, P2, S3 carrier, power-path board, cell plates, tube wires); every module plugs into it. TP4056 + power path + TPS63020 make a power block soldered and tested on the bench, linked by X10–X14, parked in the free cavity above the TP4056 (visible from the back, lid open); the boards slide in one by one with a 4–5 cm loop. Female side of the inline pairs = powered harness side. Plug / unplug only with the switch off, charger and S3 USB-C unplugged. 3 to 5 cm loop at each module to pull it out from the back before unplugging it. Volumes checked in the model and drawn in orange in the sections (renders/tars4_column_sections.svg).

## Notes

Power: TPS63020 (buck-boost, 3.3 V, EN to VIN, PS/SYNC to GND) in the left leg, 3.3 V straight to the S3 3V3 pin. Software cut-off at 3.3 V on B+ (VBAT/2 on GPIO1). The S3 internal regulator is only used on USB. Firmware: ignore the cut-off if B+ < 2.5 V or if USB_DET is high (S3 powered from the PC USB, switch off), and keep BL_EN and AMP_SD low until the supply is validated.

Resettable fuses F1, F2 (PPTC 30 V, 1.6 A) on the + of each cell, flat on the upper shelf of each leg (z 100.5–103.7); D3 (TVS) and C9 (22 µF) on the TP4056 IN pads, R_PROG 2.4 k (0.5 A charge); twisted pairs B+/B−, amplifier VSYS/GND and microSD CLK/GND; tubes deburred, heat-shrink at the tube exits.

BL_EN (GPIO7) only drives the backlight (BLK) of both screens: PWM possible. R4 10 k holds it low at boot; PWM at ~20 kHz. The AM312 has its own filter on P2 (R21 100 Ω + C12 10 µF tantalum), and P2 its decoupling (C10 10 µF + C11 100 nF). AMP_SD (GPIO4) has its own wire: R10 1 k in series and R18 10 k to GND on P2, the amplifier stays off at boot and in sleep; high → left channel: send the same sample on both channels.

Mains: a USB charger on the micro-USB socket of the left foot powers TARS (≈ 4.7 V on VSYS) while the cells charge on their own.

Before joining the two cells: same model, same age, voltages equal within 0.05 V.

The S3 VBUS pin only gets its own USB-C: the PC 5 V never goes back to the cells, flash with the switch on or off.

ADXL345 and mic in the controller column, wired locally; DS3231 and BME280 in the right leg, through the right tube (I2C ×2, 3V3, GND from P2). Every module plugs in through a connector (see the table above).

DS3231 ZS-042 with a CR2032 (not rechargeable): remove the charging resistor (200 Ω) or the diode near the coin-cell holder, otherwise the board tries to charge the cell.

ADXL345 on I2C: CS → 3V3, SDO → GND (address 0x53); INT1 → GPIO2 for wake on tap. Pins cut flush on the wall side.

INMP441 mic: chip side against the wall, the hole of the metal can facing the Ø1 hole drilled in the vertical groove. Adhesive foam gasket around it, never glue on the hole.

microSD: 3.3 V reader without regulator, flat in the left leg (z ≈ 117), under the TPS63020 and the TP4056 (z ≈ 125 / 136), socket towards the lid; the card goes in through the slot of the left leg lid (part lid_leg_sd), without opening. ~30 cm of wire from the S3: SDMMC at 10 MHz, R11 33 Ω on CLK. Free GPIOs of your choice (the ESP32-S3 matrix routes SDMMC anywhere). Its 3V3 goes through Q5 (AO3401A, R22 100 k on the gate) on the power-path board: cut in sleep, GPIO36 (SD_EN) low = on; set CLK / CMD / D0 as inputs before cutting.

Switch recessed in the floor, lever 0.5 mm back: flip it with a pen tip through the slot.

Screen 2 RST goes through the tube (forgotten in the old count of 6 SPI wires).
