arcadien/tars/hardware/kicad/tars4.kicad_sch

## KiCad design hardware/kicad/tars4.kicad_sch (2026-10-29)

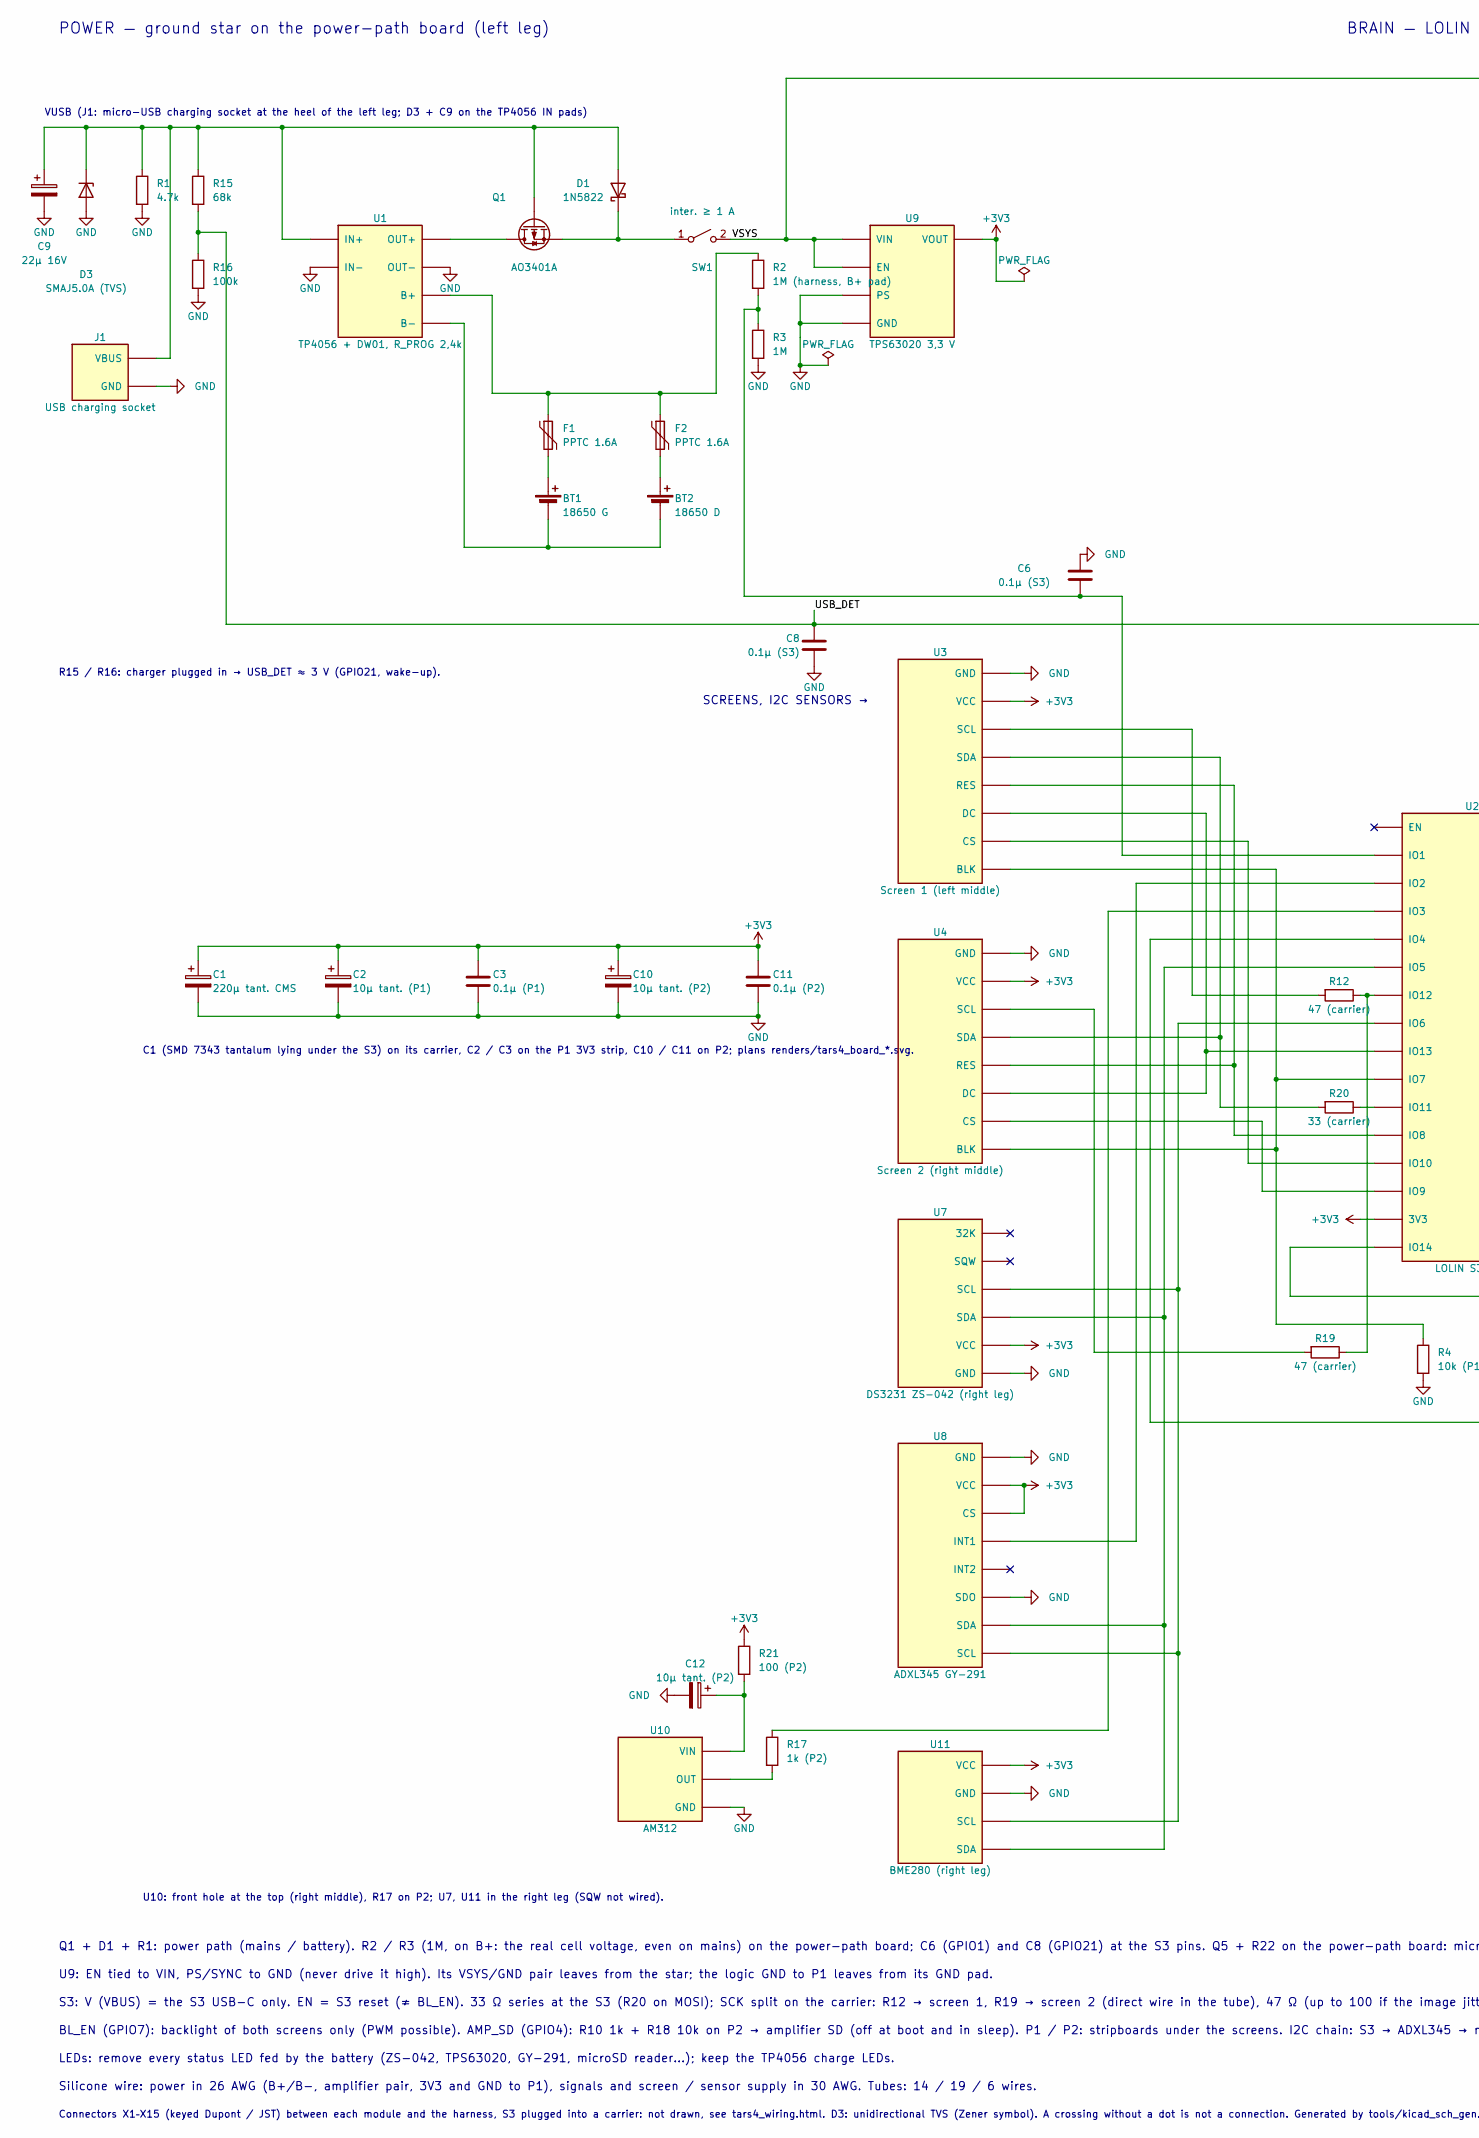
[picture p56: schematic tars4.kicad_sch, part in row 1, column 1]

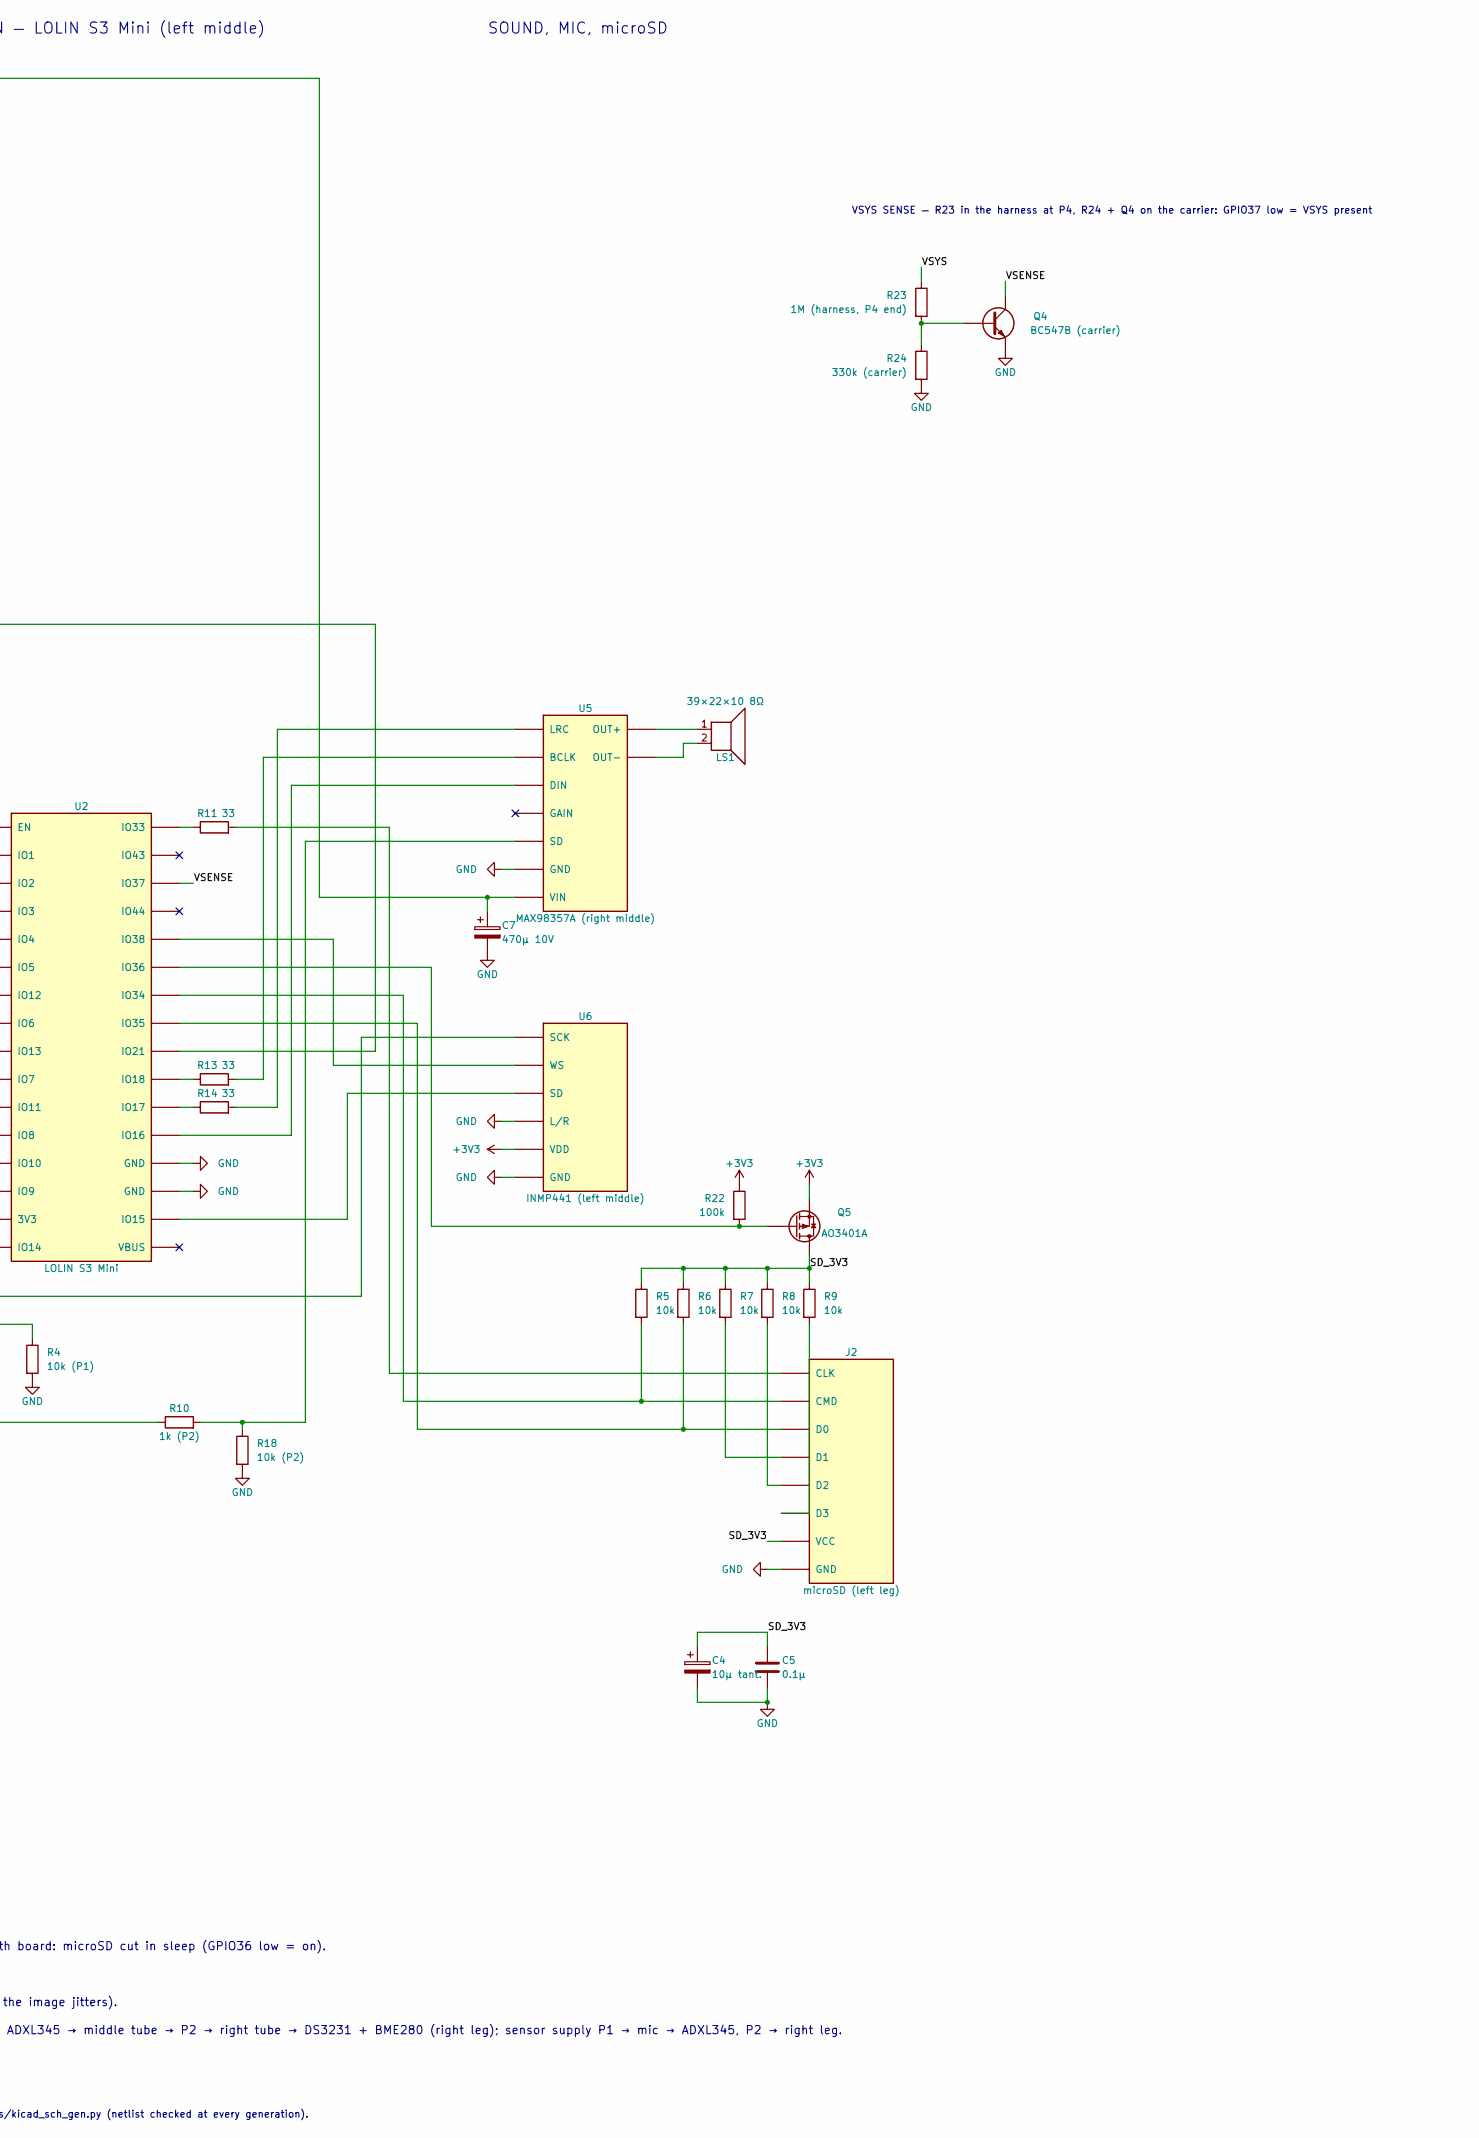
[picture p57: schematic tars4.kicad_sch, part in row 1, column 2]

Parts:
BT1: 18650 G
BT2: 18650 D
C1: 220µ tant. CMS
C2: 10µ tant. (P1)
C3: 0.1µ (P1)
C4: 10µ tant.
C5: 0.1µ
C6, C8: 0.1µ (S3)
C7: 470µ 10V
C9: 22µ 16V
C10, C12: 10µ tant. (P2)
C11: 0.1µ (P2)
D1: 1N5822
D3: SMAJ5.0A (TVS)
F1, F2: PPTC 1.6A
J1: USB charging socket
J2: microSD (left leg)
LS1: 39×22×10 8Ω
Q1, Q5: AO3401A
Q4: BC547B (carrier)
R1: 4.7k
R2: 1M (harness, B+ pad)
R3: 1M
R4: 10k (P1)
R5, R6, R7, R8, R9: 10k
R10, R17: 1k (P2)
R11, R13, R14: 33
R12, R19: 47 (carrier)
R15: 68k
R16, R22: 100k
R18: 10k (P2)
R20: 33 (carrier)
R21: 100 (P2)
R23: 1M (harness, P4 end)
R24: 330k (carrier)
SW1: inter. ≥ 1 A
U1: TP4056 + DW01, R_PROG 2,4k
U2: LOLIN S3 Mini
U3: Screen 1 (left middle)
U4: Screen 2 (right middle)
U5: MAX98357A (right middle)
U6: INMP441 (left middle)
U7: DS3231 ZS-042 (right leg)
U8: ADXL345 GY-291
U9: TPS63020 3,3 V
U10: AM312
U11: BME280 (right leg)

Connections:
+3V3: C1.1, C2.1, C3.1, C10.1, C11.1, Q5.S, R21.1, R22.1, U2.3V (3V3), U3.VCC, U4.VCC, U6.VDD, U7.VCC, U8.CS, U8.VCC, U9.VOUT, U11.VCC
GND: C1.2, C2.2, C3.2, C4.2, C5.2, C6.2, C7.2, C8.2, C9.2, C10.2, C11.2, C12.2, D3.2 (A), J1.GND, J2.GND, Q4.E, R1.2, R3.2, R4.2, R16.2, R18.2, R24.2, U1.IN-, U1.OUT-, U2.G1 (GND), U2.G2 (GND), U3.GND, U4.GND, U5.GND, U6.GND, U6.L/R, U7.GND, U8.GND, U8.SDO, U9.GND, U9.PS, U10.GND, U11.GND
unnamed: BT1.1 (+), F1.2
unnamed: BT1.2 (-), BT2.2 (-), U1.B-
unnamed: BT2.1 (+), F2.2
unnamed: C6.1, R2.2, R3.1, U2.1 (IO1)
unnamed: C9.1, D1.2 (A), D3.1 (K), J1.VBUS, Q1.G, R1.1, R15.1, U1.IN+
unnamed: C12.1, R21.2, U10.VIN
unnamed: D1.1 (K), Q1.S, SW1.1 (A)
unnamed: F1.1, F2.1, R2.1, U1.B+
unnamed: J2.CLK, R11.2
unnamed: J2.CMD, R5.2, U2.34 (IO34)
unnamed: J2.D0, R6.2, U2.35 (IO35)
unnamed: J2.D1, R7.2
unnamed: J2.D2, R8.2
unnamed: J2.D3, R9.2
unnamed: LS1.1, U5.OUT+
unnamed: LS1.2, U5.OUT-
unnamed: Q1.D, U1.OUT+
unnamed: Q4.B, R23.2, R24.1
unnamed: Q5.G, R22.2, U2.36 (IO36)
unnamed: R4.1, U2.7 (IO7), U3.BLK, U4.BLK
unnamed: R10.1, U2.4 (IO4)
unnamed: R10.2, R18.1, U5.SD
unnamed: R11.1, U2.33 (IO33)
unnamed: R12.1, R19.1, U2.12 (IO12)
unnamed: R12.2, U3.SCL
unnamed: R13.1, U2.18 (IO18)
unnamed: R13.2, U5.BCLK
unnamed: R14.1, U2.17 (IO17)
unnamed: R14.2, U5.LRC
unnamed: R17.1, U2.3 (IO3)
unnamed: R17.2, U10.OUT
unnamed: R19.2, U4.SCL
unnamed: R20.1, U2.11 (IO11)
unnamed: R20.2, U3.SDA, U4.SDA
unnamed: U2.2 (IO2), U8.INT1
unnamed: U2.8 (IO8), U3.RES, U4.RES
unnamed: U2.9 (IO9), U4.CS
unnamed: U2.10 (IO10), U3.CS
unnamed: U2.13 (IO13), U3.DC, U4.DC
unnamed: U2.14 (IO14), U6.SCK
unnamed: U2.15 (IO15), U6.SD
unnamed: U2.16 (IO16), U5.DIN
unnamed: U2.38 (IO38), U6.WS
unnamed: U2.6 (IO6), U7.SCL, U8.SCL, U11.SCL
unnamed: U2.5 (IO5), U7.SDA, U8.SDA, U11.SDA
SD_3V3: C4.1, C5.1, J2.VCC, Q5.D, R5.1, R6.1, R7.1, R8.1, R9.1
USB_DET: C8.1, R15.2, R16.1, U2.21 (IO21)
VSENSE: Q4.C, U2.37 (IO37)
VSYS: C7.1, R23.1, SW1.2 (B), U5.VIN, U9.EN, U9.VIN

Notes on the sheet:
VSYS SENSE — R23 in the harness at P4, R24 + Q4 on the carrier: GPIO37 low = VSYS present
U10: front hole at the top (right middle), R17 on P2; U7, U11 in the right leg (SQW not wired).
U9: EN tied to VIN, PS/SYNC to GND (never drive it high). Its VSYS/GND pair leaves from the star; the logic GND to P1 leaves from its GND pad.
C1 (SMD 7343 tantalum lying under the S3) on its carrier, C2 / C3 on the P1 3V3 strip, C10 / C11 on P2; plans renders/tars4_board_*.svg.
LEDs: remove every status LED fed by the battery (ZS-042, TPS63020, GY-291, microSD reader…); keep the TP4056 charge LEDs.
R15 / R16: charger plugged in → USB_DET ≈ 3 V (GPIO21, wake-up).
S3: V (VBUS) = the S3 USB-C only. EN = S3 reset (≠ BL_EN). 33 Ω series at the S3 (R20 on MOSI); SCK split on the carrier: R12 → screen 1, R19 → screen 2 (direct wire in the tube), 47 Ω (up to 100 if the image jitters).
SOUND, MIC, microSD
BL_EN (GPIO7): backlight of both screens only (PWM possible). AMP_SD (GPIO4): R10 1k + R18 10k on P2 → amplifier SD (off at boot and in sleep). P1 / P2: stripboards under the screens. I2C chain: S3 → ADXL345 → middle tube → P2 → right tube → DS3231 + BME280 (right leg); sensor supply P1 → mic → ADX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
SCREENS, I2C SENSORS →
VUSB (J1: micro-USB charging socket at the heel of the left leg; D3 + C9 on the TP4056 IN pads)
Connectors X1–X15 (keyed Dupont / JST) between each module and the harness, S3 plugged into a carrier: not drawn, see tars4_wiring.html. D3: unidirectional TVS (Zener symbol). A crossing without a dot is not a connection. Generated by tools/kicad_sch_gen.py (netlist checked at every generation).
Silicone wire: power in 26 AWG (B+/B−, amplifier pair, 3V3 and GND to P1), signals and screen / sensor supply in 30 AWG. Tubes: 14 / 19 / 6 wires.
Q1 + D1 + R1: power path (mains / battery). R2 / R3 (1M, on B+: the real cell voltage, even on mains) on the power-path board; C6 (GPIO1) and C8 (GPIO21) at the S3 pins. Q5 + R22 on the power-path board: microSD cut in sleep (GPIO36 low = on).
POWER — ground star on the power-path board (left leg)
BRAIN — LOLIN S3 Mini (left middle)
