arcadien/tars/(commit log)

2026-10-28 TARS4: initial snapshot (model with the 2026-10-27 measurements merged)
    Model tars4.scad with the measured parts merged (STL / 3MF not regenerated yet:
    waiting for tube test 3), KiCad schematic, hand-wired board plans, wiring guide
    recoloured to the power-pair rule with coloured bands on the red / black rails,
    Orca projects (Ender 3, CR-10), renders, docs and the incremental make check.
    [column_sections.scad, tars4.3mf, tars4.kicad_sch, tars4.scad, tars4_col0_bottom.stl, tars4_col0_top.stl, tars4_col1_bottom.stl, tars4_col1_top.stl]
2026-10-28 Regenerate STL, renders and harness from the 2026-10-27 merged model
    Tube bores still wait for tube test3: don't print the columns from these yet.
    [tars4_col0_bottom.stl, tars4_col0_top.stl, tars4_col1_bottom.stl, tars4_col1_top.stl, tars4_col2_bottom.stl, tars4_col2_top.stl, tars4_col3_bottom.stl, tars4_col3_top.stl]
2026-10-28 docs: CLAUDE.md language rule (English docs); power budget table per module
2026-10-28 docs: power budget, VSYS sense is an NPN level detector
2026-10-28 docs: translate the wiring page (tars4_wiring.html, renders/tars4_wiring.svg) to English
2026-10-28 docs: translate the schematic page (tars4_schematic.html) to English
2026-10-28 docs: translate the KiCad schematic notes and labels to English (kicad_sch_gen.py, schematic, PDF)
    [tars4.kicad_sch]
2026-10-28 docs: translate the column and tube section drawings to English
2026-10-28 docs: translate the wiring guide and board plans to English (harness.py, boards.py and their outputs)
2026-10-28 docs: translate the connector and keep-out labels in tars4.scad (column sections); STL re-exported, geometry unchanged
    [tars4.scad, tars4_col0_bottom.stl, tars4_col0_top.stl, tars4_col1_bottom.stl, tars4_col1_top.stl, tars4_col2_bottom.stl, tars4_col2_top.stl, tars4_col3_bottom.stl]
2026-10-28 docs: README, D1 leakage test at 35 °C instead of 50 °C (D1 only blocks on battery)
2026-10-28 req(FUNC-POWER-CHARGE-001): Battery charges from an external 5 V USB supply
2026-10-28 req(FUNC-POWER-PATH-001): On an external supply, the system load does not draw from the battery
2026-10-28 req(FUNC-POWER-PATH-002): Connecting or disconnecting the external supply does not reset the robot
2026-10-28 req(FUNC-POWER-SWITCH-001): The power switch turns the robot off
2026-10-28 req(FUNC-POWER-SWITCH-002): Charging works with the power switch off
2026-10-28 req(FUNC-POWER-MONITOR-001): Firmware measures the battery voltage
2026-10-28 req(FUNC-POWER-MONITOR-002): Battery level classification ("hunger")
2026-10-28 req(FUNC-POWER-MONITOR-003): Charging and full states replace the level on an external supply
2026-10-28 req(FUNC-POWER-DETECT-001): Firmware detects the external supply
2026-10-28 req(FUNC-POWER-DETECT-002): Connecting the external supply wakes the robot
2026-10-28 req(FUNC-POWER-VSENSE-001): Firmware detects that the system rail is powered
2026-10-28 req(FUNC-POWER-CUTOFF-001): Low-battery shutdown
2026-10-28 req(FUNC-POWER-CUTOFF-002): An empty battery stays asleep until it is charging and above 3.5 V
2026-10-28 req(FUNC-POWER-GATE-001): Firmware can cut the supply of the removable storage card
2026-10-28 req(TECH-POWER-CELL-001): One 1S2P lithium-ion pack behind a single charger and protection circuit
2026-10-28 req(TECH-POWER-CELL-002): Cells matched before they are put in parallel
2026-10-28 req(TECH-POWER-CHARGE-001): Lithium-ion CC/CV charge with termination at 4.20 V
2026-10-28 req(TECH-POWER-PROTECT-001): Hardware protection of the pack against over-discharge, overcharge and overcurrent
2026-10-28 req(TECH-POWER-PROTECT-002): Resettable fuse on each cell branch
2026-10-28 req(TECH-POWER-HOTPLUG-001): Charger input protected against hot-plug overshoot
2026-10-28 req(TECH-POWER-VBUS-001): The programming port never powers the system rail or the battery (draft: pending measurement)
2026-10-28 req(TECH-POWER-BACKFEED-001): Outputs to rail-powered peripherals stay low until the system rail is present
2026-10-28 req(TECH-POWER-GROUND-001): Star ground on the pack output
2026-10-28 req(TECH-POWER-DIST-001): Separate supply pairs for the 3.3 V regulator and the audio amplifier
2026-10-28 req(TECH-POWER-REG-001): A single 3.3 V logic rail from a buck-boost converter
2026-10-28 req(TECH-POWER-REG-002): The 3.3 V rail tolerates a second source from the controller's LDO
2026-10-28 req(TECH-POWER-SLEEP-001): No always-on indicator loads on battery-fed rails
2026-10-28 req(PERF-POWER-REG-001): 3.3 V rail static regulation
2026-10-28 req(PERF-POWER-REG-002): 3.3 V rail under load transients
2026-10-28 req(PERF-POWER-PATH-001): Power-path voltage drop
2026-10-28 req(PERF-POWER-CHARGE-001): Full charge time
2026-10-28 req(PERF-POWER-THERMAL-001): Leg wall temperature while charging
2026-10-28 req(PERF-POWER-MAINS-001): External supply voltage under the maximum combined load
2026-10-28 req(PERF-POWER-MONITOR-001): Battery voltage measurement accuracy (draft: pending measurement)
2026-10-28 req(PERF-POWER-SLEEP-001): Deep-sleep current from the battery (draft: pending measurement)
2026-10-28 req(PERF-POWER-OFF-001): Battery drain with the switch off (draft: pending measurement)
2026-10-28 req(PERF-POWER-RUNTIME-001): Runtime on a full charge
2026-10-28 req(CONF-POWER-THRESH-001): Battery thresholds are configuration values
2026-10-28 req(CONF-POWER-ADCCAL-001): Battery-measurement calibration is configurable (draft: pending measurement)
2026-10-28 req(PLAT-POWER-CHARGE-001): Protected TP4056 module charged through a separate micro-USB breakout
2026-10-28 req(PLAT-POWER-CHARGE-002): Charge current set to 0.5 A by R_PROG 2.4 kΩ
2026-10-28 req(PLAT-POWER-HOTPLUG-001): TVS D3 and capacitor C9 on the TP4056 input pads
2026-10-28 req(PLAT-POWER-PROTECT-001): The DW01 on the TP4056 module protects the pack (draft: pending measurement)
2026-10-28 req(PLAT-POWER-FUSE-001): XF160 polyfuses F1 / F2 at each cell's + plate
2026-10-28 req(PLAT-POWER-PATH-001): Power path Q1 / D1 / R1 on the power-path board (draft: pending measurement)
2026-10-28 req(PLAT-POWER-SWITCH-001): Slide switch SW1 between VPATH and VSYS (draft: pending measurement)
2026-10-28 req(PLAT-POWER-REG-001): TPS63020 module U9 makes the 3.3 V rail
2026-10-28 req(PLAT-POWER-REG-002): TPS63020 PS/SYNC tied to GND (power-save mode)
2026-10-28 req(PLAT-POWER-REG-003): C1 220 µF low-ESR polymer capacitor at the S3 3V pin
2026-10-28 req(PLAT-POWER-DIST-001): MAX98357A fed from its own VSYS pair, with C7 470 µF
2026-10-28 req(PLAT-POWER-MONITOR-001): VBAT/2 divider R2 / R3 into GPIO1 (ADC1)
2026-10-28 req(PLAT-POWER-DETECT-001): USB_DET divider R15 / R16 into GPIO21
2026-10-28 req(PLAT-POWER-VSENSE-001): VSYS sense: NPN level detector into GPIO37
2026-10-28 req(PLAT-POWER-VBUS-001): S3 Mini VBUS contact removed from the carrier header (draft: pending measurement)
2026-10-28 req(PLAT-POWER-GATE-001): Q5 switches the microSD 3V3 from SD_EN on GPIO36
2026-10-28 req(PLAT-POWER-SLEEP-001): Battery-fed status LEDs removed
2026-10-28 req(PLAT-POWER-SLEEP-002): DS3231 32 kHz output disabled
2026-10-28 refactor: split the repo into physical/ (scad, stl, 3mf), hardware/ (kicad, wiring, budgets, measurements, shopping list) and software/ (promicro)
    Paths updated in build4.sh, check.sh, orca_check.py, update_orca_project.py, kicad_sch_gen.py, harness.py,
    column_sections.py, wiring_svg.js, README, CLAUDE.md and the requirement links. make check passes (FORCE=1).
    [column_sections.scad, tars4.3mf, tars4.kicad_sch, tars4.scad, tars4_col0_bottom.stl, tars4_col0_top.stl, tars4_col1_bottom.stl, tars4_col1_top.stl]
2026-10-28 refactor: rename physical/ to mechanical/, add CONTRIBUTING.md (offline model workflow), stop exporting test_level and test_screen
    [column_sections.scad, tars4.3mf, tars4.scad, tars4_col0_bottom.stl, tars4_col0_top.stl, tars4_col1_bottom.stl, tars4_col1_top.stl, tars4_col2_bottom.stl]
2026-10-28 refactor: stop exporting the finished trial prints pir_test, tube_test, tube_test2 (kept in the model)
    [tars4_col0_bottom.stl, tars4_col0_top.stl, tars4_col1_bottom.stl, tars4_col1_top.stl, tars4_col2_bottom.stl, tars4_col2_top.stl, tars4_col3_bottom.stl, tars4_col3_top.stl]
2026-10-28 req(FUNC-POWER-CHARGE-001): charge port on the heel of the left leg, reachable with the robot standing
2026-10-28 req(PLAT-POWER-CHARGE-001): micro-USB breakout facing backwards through the bottom of the left leg's lid
2026-10-28 req(PLAT-MECH-CHARGEPORT-001): charge port at the heel of the left leg, breakout on the outer side wall
2026-10-28 feat(PLAT-MECH-CHARGEPORT-001): charge port moved to the heel of the left leg
    The micro-USB breakout now stands against the outer side wall of the foot, receptacle facing backwards through a notch
    at the bottom of the lid (centre 10.3 above the floor), so TARS charges standing up. Bottom block and top rail with
    edge grooves, front stop in two tabs, the lid as pull-out stop; floor opening removed. Geometry checks in tars4.scad.
    usbb_out and usbb_rec still MEASURE: the branch is merged only after these measurements (open_questions CP1).
    STLs, renders, harness guide and both Orca projects regenerated.
    [tars4.3mf, tars4.scad, tars4_col0_bottom.stl, tars4_col0_top.stl, tars4_col1_bottom.stl, tars4_col1_top.stl, tars4_col2_bottom.stl, tars4_col2_top.stl]
2026-10-28 docs: MAX98357A board 22.4 x 38.4 and speaker 66 x 30 x 17 measured (not merged into the model: the speaker does not fit)
2026-10-28 feat(PLAT-MECH-CHARGEPORT-001): close-up renders of the heel (lid on, lid off from the back right) in build4.sh and the README
    [tars4_col0_bottom.stl, tars4_col0_top.stl, tars4_col1_bottom.stl, tars4_col1_top.stl, tars4_col2_bottom.stl, tars4_col2_top.stl, tars4_col3_bottom.stl, tars4_col3_top.stl]
2026-10-28 chore: make check remembers every input digest that passed, so switching branches does not re-export STLs and renders
2026-10-28 chore: make check runs on Windows (cygpath paths in render includes, UTF-8 text files)
    build4.sh wrote `include </c/...>` into the render snippets, which Windows OpenSCAD cannot open; it now passes the
    `cygpath -m` form, like TMP. boards.py and harness.py read and write their SVG / HTML / JSON in UTF-8 instead of the
    platform default (cp1252 on Windows fails on the Ω of the resistor values; `python3 -I` ignores PYTHONUTF8).
    [boards.py, harness.py]
2026-10-28 docs: micro-USB breakout receptacle measured (mouth ~1.1 past the PCB edge, shell 7.85 x 2.47)
2026-10-28 feat(PLAT-MECH-CHARGEPORT-001): measured receptacle folded in (usbb_out 1.1, usbb_rec 7.85 x 2.47)
    Lid notch 8.45 x 3.07 (bottom 6.0 above the floor), mouth 0.7 inside the back face, receptacle 0.755 from the
    switch frame; no model warning. connectors.scad (XH() for the connector detail in the renders) now lives next to
    tars4.scad. STLs, renders and harness guide regenerated; CP1 closed in open_questions.md.
    [connectors.scad, tars4.scad, tars4_col0_bottom.stl, tars4_col0_top.stl, tars4_col1_bottom.stl, tars4_col1_top.stl, tars4_col2_bottom.stl, tars4_col2_top.stl]
2026-10-28 chore: Orca projects leave the change workflow (plates refreshed and arranged by hand in Orca)
2026-10-28 req(TECH-BUILD-ARTIFACTS-001): STLs and raw plates are build outputs, ignored by git; OpenSCAD version pinned
2026-10-28 tech(TECH-BUILD-ARTIFACTS-001): STLs and raw plates leave git (build outputs, `make check-stl` before a print)
    mechanical/stl/ and mechanical/3mf/tars4_plate*.3mf are ignored and untracked; the Orca projects, renders and
    documents stay versioned. History is kept as is (no rewrite).
    [tars4_col0_bottom.stl, tars4_col0_top.stl, tars4_col1_bottom.stl, tars4_col1_top.stl, tars4_col2_bottom.stl, tars4_col2_top.stl, tars4_col3_bottom.stl, tars4_col3_top.stl]
2026-10-28 tech(TECH-BUILD-CHECKS-001): fast pre-commit, slow pre-push, CI job `check` with the pinned OpenSCAD
    - check.sh: new `model` stage (tars4.scad evaluated without export, fails on any WARNING / ERROR, < 1 s)
    - pre-commit runs model + erc + docs; new pre-push runs stl + renders; `make hook` installs all three hooks
    - .github/workflows/check.yml: OpenSCAD 2026.10.27 AppImage (sha256-checked, cached: nightlies get pruned),
    KiCad 10 and Ghostscript, then model + stl + erc + docs; renders stay in the pre-push hook (need a display)
    - CLAUDE.md / CONTRIBUTING.md: pinned version, hook split, CI gate
2026-10-28 req(PLAT-MECH-PIVOT-001): teardrop pivot bores, glued 8.00 / turning 8.05 for the 7.93 tube
    Validated by Aurelien 2026-10-28 from tube_test3. Renders and harness PDF re-run with the
    pinned OpenSCAD 2026.10.27 nightly (no model change).
2026-10-28 tech(TECH-BUILD-CHECKS-001): hooks are shims to the branch's own scripts; the cache keys on the OpenSCAD version
    .git/hooks is shared by every worktree: a copied hook from one branch broke commits on branches without the `model`
    stage. `make hook` now installs scripts/hook-shim under each name, which runs the checked-out branch's scripts/<hook>
    (nothing when the branch has none). check.sh's stage digest includes `openscad --version`, so switching OpenSCAD
    re-runs the stages.
2026-10-28 feat(PLAT-MECH-PIVOT-001): teardrop pivot bores, glued 8.00 / turning 8.05 for the 7.93 tube
    tube_od 7.93, tube_glue_clr 0.07, tube_run_clr 0.12; pivot_cut uses xtear on both
    sides (point up when the columns print front face down). tube_test3: G8.00 holds
    with no play, R8.05 turns with micro play. STLs, renders and docs refreshed.
    [tars4.scad, tars4_col0_bottom.stl, tars4_col0_top.stl, tars4_col1_bottom.stl, tars4_col1_top.stl, tars4_col2_bottom.stl, tars4_col2_top.stl, tars4_col3_bottom.stl]
2026-10-28 tech(TECH-BUILD-ARTIFACTS-001): build4.sh creates mechanical/stl/ (absent on a fresh clone, failed the first CI run)
2026-10-28 tech(TECH-BUILD-CHECKS-001): html2pdf waits up to 90 s for Firefox (cold snap start on CI runners timed out at 30 s)
    [html2pdf.py]
2026-10-28 fix(TECH-BUILD-CHECKS-001): the stl stage checks the CR-10 plate on its 300 x 300 bed
    Only the Ender 3 plates were laid out and checked; a one-piece CR-10 part growing past the bed passed make check
    and CI. build4.sh cr10 honours PLATE_DIR, and the stl stage builds that plate in build/plates and fails on its
    WARNING. The raw CR-10 plate is ignored by git like the Ender 3 ones.
2026-10-28 fix(TECH-BUILD-CHECKS-001): harness.py refuses a geometry cache older than tars4.scad
    Without openscad on Python's PATH it silently reused tools/harness_geometry.json, so the harness guide could come out
    with old module positions (wrong wire lengths) and no error. It now stops unless the cache is newer than the model,
    and says when it uses it.
    [harness.py]
2026-10-28 fix(TECH-BUILD-CHECKS-001): harness PDF dates pinned, so an unchanged guide gives the same bytes
    Firefox stamped /CreationDate and /ModDate on every run: the PDF was rewritten byte-different each time the docs
    stage ran, and the pre-commit hook refused the commit once more. Both dates are set to 2000-01-01 (same length,
    xref offsets unchanged).
    [harness.py]
2026-10-28 fix(TECH-BUILD-CHECKS-001): stage inputs list every model file and the schematic generator
    docs did not list tools/kicad_sch_gen.py, whose nets boards.py checks the board plans against: a net change ran the
    ERC but skipped that check. stl / renders / docs listed only tars4.scad (not connectors.scad, used by the renders);
    they now take mechanical/scad/*.scad. The OpenSCAD library folder is no longer an input: the model includes only
    local files.
2026-10-28 fix(TECH-BUILD-ARTIFACTS-001): pose renders take their dimensions from tars4.scad
    The pose scene copied D, gap, H, wall, the pivot height, the speaker box (22 x 10 x 39 at y 3, z 30) and an 8 mm tube
    by hand ("must match tars4.scad"); the speaker face had already drifted (3 vs 3.35) and the tube (8 vs 7.93). It now
    includes the model with part="none" and uses pivot_z, spk, spk_front_y, spk_z0 and tube_od, so the coming speaker
    change shows up in the renders. Pixels unchanged today.
2026-10-28 fix(TECH-BUILD-CHECKS-001): check.sh finds kicad-cli and gswin64c on the PATH, not only the Linux AppImage / gs
    The ERC looked only for a KiCad AppImage in ~/bin and the PDF check only for `gs`: with KiCad or Ghostscript
    installed normally (Windows, CI), every commit touching the schematic was refused unless wrapper scripts faked the
    AppImage. ERC now uses the AppImage if any, else kicad-cli; Ghostscript is gs, else gswin64c. The CI drops its
    kicad wrapper.
2026-10-28 fix(TECH-BUILD-CHECKS-001): render errors are shown instead of discarded
    Every OpenSCAD call of build_renders sent stderr to /dev/null: when the OpenSCAD install lost its colour schemes
    the renders stage only said "stale", without the reason. stderr now goes to a file whose last 20 lines are printed
    when a render fails.
2026-10-28 fix(TECH-BUILD-ARTIFACTS-001): KiCad backup zip and local .kicad_prl leave git
    The automatic backup of 2026-10-23 and the per-user project settings (open sheets, zoom, layer visibility) are not
    sources: the .kicad_prl changes whenever the project is opened. Both are untracked and ignored; the files stay on
    disk.
2026-10-28 plan: status.md for test-schematic (acceptance tests on the KiCad netlist)
2026-10-28 test(TECH-POWER-CELL-001): one charger / protection module, both cells on its B+ and B- nets
    tests/conftest.py exports the schematic once per run as a KiCad XML netlist (kicad-cli, or $KICAD) and finds nets through their pins; TARS_NETLIST runs the tests on a given netlist. Read from the KiCad project (kicad-cli XML netlist), checked against a deliberately broken netlist: the test fails.
    [test_power.py]
2026-10-28 test(TECH-POWER-PROTECT-002): one polyfuse between each cell + and BAT+
    Read from the KiCad project (kicad-cli XML netlist), checked against a deliberately broken netlist: the test fails.
    [test_power.py]
2026-10-28 test(TECH-POWER-GROUND-001): no load ground on the raw cell negative B-
    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
    [test_power.py]
2026-10-28 test(TECH-POWER-REG-001): one buck-boost from VSYS feeds every 3.3 V load
    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
    [test_power.py]
2026-10-28 test(TECH-POWER-DIST-001): separate VSYS / GND pairs for the regulator and the amplifier, 3V3 pair from the regulator
    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
    [test_power.py]
2026-10-28 tech(TECH-BUILD-CHECKS-001): the erc stage runs the requirement acceptance tests (pre-commit and CI)
    After the ERC, `uvx pytest -q tests` checks the requirements on the same schematic; the stage also re-runs when the
    tests or the boards.py / harness.py wire lists change. CI installs uv.
2026-10-28 test(PLAT-POWER-HOTPLUG-001): SMAJ5.0A TVS and 22 µF across VUSB, the right way round
    Read from the KiCad netlist; checked against a deliberately broken netlist: the test fails.
    [test_platform.py]
2026-10-28 test(PLAT-POWER-REG-002): TPS63020 PS/SYNC tied to GND
    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
    [test_platform.py]
2026-10-28 test(PLAT-POWER-REG-003): C1 220 µF polarised on +3V3 at the S3's 3V pin
    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
    [test_platform.py]
2026-10-28 test(PLAT-POWER-DIST-001): amplifier VIN on VSYS, GND on GND, C7 across, own harness pair
    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
    [test_platform.py]
2026-10-28 test(PLAT-POWER-MONITOR-001): R2 / R3 1M divider from B+ to GPIO1, C6 100 nF ceramic
    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
    [test_platform.py]
2026-10-28 test(PLAT-POWER-DETECT-001): R15 68k / R16 100k USB_DET on GPIO21, C8 100 nF
    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
    [test_platform.py]
2026-10-28 test(PLAT-POWER-VSENSE-001): NPN from VSYS to GPIO37 (strict xfail: not drawn yet)
    The requirement says the NPN is not in the schematic yet: the test is a strict xfail, so it turns red (XPASS) once the circuit is drawn, and the mark must then be removed.
2026-10-28 test(PLAT-POWER-GATE-001): Q5 switches +3V3 to the microSD reader, gate on GPIO36 pulled up by R22
    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
    [test_platform.py]
2026-10-28 test(PLAT-POWER-CHARGE-001): J1 VBUS / GND on the TP4056 IN pads, OUT+ the only charger output
    Strict xfail: J1 is only a text note in the schematic so far; the fix that draws it removes the mark.
    [test_platform.py]
2026-10-28 fix(TECH-BUILD-CHECKS-001): kicad_sch_gen.py finds kicad-cli outside the Linux AppImage path, writes UTF-8
    Without ~/bin/kicad-10.0.7-x86_64.AppImage it silently skipped the KiCad upgrade and the netlist comparison. It now
    takes $KICAD, the newest ~/bin/kicad-*.AppImage, or kicad-cli on the PATH, and warns when there is none. Files are
    read and written in UTF-8 (cp1252 on Windows would mangle µ / Ω). Output unchanged (same bytes).
    [kicad_sch_gen.py]
2026-10-28 fix(PLAT-POWER-CHARGE-001): J1, the micro-USB charging socket, drawn in the schematic
    J1 was only a text note, so the netlist had no breakout and the requirement's acceptance (its VBUS / GND on the TP4056
    IN+ / IN- pads) could not be checked. New module symbol tars:usb_charging_socket (VBUS, GND; usbb in tars4.scad) on
    VUSB and GND; the note now says "heel" (the port moved there in mech-usb-heel). Netlist check OK (49 nets), ERC
    clean, schematic PDF exported; the acceptance test loses its xfail mark.
    [tars4.kicad_sch]
2026-10-28 tech(TECH-BUILD-CHECKS-001): the erc stage re-runs on any test input (model, sheets, requirements, exclusions)
    Its input list also carried literal \n instead of line continuations (d6f9551); fixed.
2026-10-28 test(PLAT-MECH-CHARGEPORT-001): model clean with its charge-port asserts; print sheet (10 plug cycles)
2026-10-28 test(PLAT-MECH-PIVOT-001): tube 7.93, clearances 0.07 / 0.12, teardrop bores only; print sheet (first joint)
    [test_mechanical.py]
2026-10-28 test(TECH-BUILD-ARTIFACTS-001): no STL or raw plate tracked, both paths ignored
2026-10-28 test(TECH-BUILD-CHECKS-001): manual sheet of the check pipeline (pre-commit time, WARNING, bed, CI, merge gate)
2026-10-28 test(FUNC-POWER-CHARGE-001): bench test sheet — battery charges from the heel port, robot standing
2026-10-28 test(FUNC-POWER-PATH-001): bench test sheet — on the external supply, the system load does not draw from the battery
2026-10-28 test(FUNC-POWER-PATH-002): bench test sheet — plugging or unplugging the supply does not drop the system rail
2026-10-28 test(FUNC-POWER-SWITCH-001): bench test sheet — the switch turns the system rail off
2026-10-28 test(FUNC-POWER-SWITCH-002): bench test sheet — charging works the same with the switch off and on
2026-10-28 test(PERF-POWER-CHARGE-001): bench test sheet — full charge time
2026-10-28 test(PERF-POWER-MAINS-001): bench test sheet — supply voltage under the maximum combined load
2026-10-28 test(PERF-POWER-PATH-001): bench test sheet — power-path voltage drop
2026-10-28 test(PERF-POWER-REG-001): bench test sheet — 3.3 V rail static regulation
2026-10-28 test(PERF-POWER-REG-002): bench test sheet — 3.3 V rail under Wi-Fi and audio load transients
2026-10-28 test(PERF-POWER-THERMAL-001): bench test sheet — leg wall temperature while charging (E-M8)
2026-10-28 test(PLAT-POWER-CHARGE-002): bench test sheet — charge current set by R_PROG 2.4 kΩ
2026-10-28 test(PLAT-POWER-FUSE-001): bench test sheet — polyfuses F1 / F2 at each cell's + plate
2026-10-28 test(PLAT-POWER-REG-001): bench test sheet — TPS63020 module output and idle current
2026-10-28 test(PLAT-POWER-SLEEP-001): bench test sheet — battery-fed status LEDs removed
2026-10-28 test(TECH-POWER-CELL-002): bench test sheet — cells matched before they go in parallel
2026-10-28 test(TECH-POWER-CHARGE-001): bench test sheet — CC/CV charge ending at 4.20 V
2026-10-28 test(TECH-POWER-HOTPLUG-001): bench test sheet — no overshoot when the supply is hot-plugged
2026-10-28 test(TECH-POWER-PROTECT-001): bench test sheet — pack protection opens on over-discharge
2026-10-28 test(TECH-POWER-REG-002): bench test sheet — no reverse current into the regulator when the S3 LDO also drives 3V3
2026-10-28 test(TECH-POWER-SLEEP-001): bench test sheet — no always-on indicator on battery-fed rails
2026-10-28 tech(TECH-BUILD-CHECKS-001): requirement coverage check (test, sheet or exclusion for every validated requirement)
    Fails on a validated requirement with no pytest test, manual sheet, Unity tag or exclusion; warns for firmware requirements while no firmware test exists, and for sheets never run. Runs in the erc stage (pre-commit, CI).
    [test_requirements.py]
2026-10-28 plan: test-schematic status (coverage done, usbb rename and VSENSE drawing to do, T1 open)
2026-10-28 test(TECH-POWER-REG-001): note the agreed reading (a load may sit behind at most one switch / filter part)
2026-10-28 docs: open questions VS1 (VSENSE test xfail) and RF1 (usbb rename) from test-schematic
2026-10-28 plan: remove status.md before merging test-schematic
2026-10-28 tech(TECH-BUILD-CHECKS-001): pre-push refreshes the Orca project meshes (meshes stage)
    New check.sh stage `meshes`: update_orca_project.py on both Orca projects,
    no OrcaSlicer needed, incremental on the STLs and the projects. The
    pre-push hook runs it after stl and renders and refuses the push while
    the rewritten projects are not committed. update_orca_project.py leaves
    an up-to-date project untouched (no backup, no rewrite), so a push with
    current meshes sees no change.
2026-10-28 tech(TECH-BUILD-CHECKS-001): Orca projects refreshed with the teardrop pivot bores
    Meshes of tars4.3mf and tars4_cr10.3mf swapped for the current STLs
    (meshes stage), plates and positions kept.
    [tars4.3mf, tars4_cr10.3mf]
2026-10-29 docs: hardware/tars4_schematic.html replaced by hardware/design_notes.md
    The hand-drawn page duplicated the KiCad schematic and drew only P1 / P2 (the carrier and the power-path board were
    missing); the boards are the plans generated and net-checked by tools/boards.py. Its part rationale and design notes
    are kept in markdown, the stale entries fixed (F1 / F2 on the inner front wall, U10 Ø11.5 hole, LS1 not settled).
    README, CLAUDE.md and bring-up.md point to the notes, the board plans and the README Signals table.
    Committed with --no-verify (agreed): the commit-msg hook asks for a requirement ID on any hardware/ change, none
    fits a documentation removal; make check model / erc / docs run b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
2026-10-29 feat(PLAT-POWER-VSENSE-001): Q4 BC547B, R23 / R24 1 MΩ and GPIO37 in the schematic
    VSYS → R23 → base, R24 base → GND, emitter GND, collector on GPIO37 (VSENSE), drawn as a block joined by labels. Netlist OK (51 nets), ERC clean; the acceptance test loses its xfail mark.
    [tars4.kicad_sch]
2026-10-29 feat(PLAT-POWER-VSENSE-001): Q4 / R24 on the carrier, R23 in line at the power-path board, X14 to JST-XH 4
    Carrier: Q4 standing on F10-H10 (C bridged to IO37 / I10, E to the GND bus), R24 on G9-F9, VSENSE_B wire in G8. Power-path board: VSYS hole D4 (bridged to D3, no neighbour), wire to X14 pin 4 with R23 1 MΩ soldered in line near the board (the tube wire only carries VSYS behind 1 MΩ). boards.py learns TO-92 parts (kind T) and in-line resistors; harness.py writes them in the guide. X14 (XH 4) gets its own parking row in front of X10 (model clean); left tube 14 wires; renders, harness guide and wiring page regenerated.
    [tars4.scad]
2026-10-29 feat(PLAT-POWER-VSENSE-001): README, power budget, shopping list and open questions for the VSYS sense
    BOM rows Q4 / R23 / R24, Signals and battery-monitor text, X14 as JST-XH 4 (3 four-pin housings, no three-pin left), VS1 closed.
2026-10-29 req(PLAT-POWER-VSENSE-001): fitted BC547B, R23 in line in the harness at the power-path board, R24 / Q4 on the carrier
    Replaces "hardware change, not yet in kicad_sch_gen.py, the boards or the wiring" now that it is drawn and wired (validated by Aurelien, 2026-10-29).
2026-10-29 feat(PLAT-POWER-VSENSE-001): design notes row for Q4 / R23 / R24
2026-10-29 fix(TECH-BUILD-CHECKS-001): check.sh finds the Windows tools itself and says which one is missing; failed STL exports show OpenSCAD's error
    A push from a plain Git Bash failed with nineteen "no STL written" and no reason: OpenSCAD and KiCad are not on the
    Windows PATH, and build4.sh deleted OpenSCAD's own output. check.sh now looks for OpenSCAD in C:\Program Files\OpenSCAD
    (Nightly) / OpenSCAD (through openscad.com, the console binary), KiCad, Ghostscript and Firefox in their install
    folders, checks the tools of the requested stages up front (exit 2 with the missing ones), and notes an OpenSCAD other
    than the version pinned in CI. build4.sh prints the end of OpenSCAD's output for every part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
2026-10-29 req(FUNC-POWER-VSENSE-001): flag false below 2.3 V (amplifier needs 2.5 V); falling edge may be slow on the programming-port supply
    Validated by Aurelien (audit lot 1, 2026-10-29).
2026-10-29 req(PERF-POWER-PATH-001): on mains the cell charge current stays at the R_PROG value (catches a reversed Q1)
    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
2026-10-29 test(PLAT-POWER-PATH-001): Q1 / D1 the right way round (a reversed Q1 charges the cells around the charger); R1 4.7k as a strict xfail
    Checked against broken netlists: Q1 drain / source swapped, D1 reversed → the test fails.
    [test_platform.py]
2026-10-29 req(PLAT-POWER-PATH-001): R1 4.7 kΩ by design, no hot leakage measurement; validated, pytest checks Q1 / D1 orientation
    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
2026-10-29 req(PLAT-POWER-DIST-001): C7 is a Panasonic EEUFC1A471 (470 µF 10 V low ESR)
    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
2026-10-29 req(PLAT-POWER-MONITOR-001): R2 soldered in line in the harness at the B+ pad end, R3 on the power-path board
    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
2026-10-29 req(PLAT-POWER-VSENSE-001): BC547, R24 330 kΩ (threshold 2.3–2.7 V), derives from FUNC-POWER-VSENSE-001
    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
2026-10-29 req(TECH-POWER-HOTPLUG-001): hot-plug overshoot also bounded at the amplifier VIN (≤ 6.0 V), whole robot
    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
2026-10-29 feat(PLAT-POWER-PATH-001): R1 4.7 kΩ (schematic, power-path board, docs); the R1 test loses its xfail
    A warm D1 leaking up to 50 µA leaves Q1's gate below 0.25 V; VUSB falls twice as fast on unplugging.
    [boards.py, kicad_sch_gen.py, test_platform.py]
2026-10-29 feat(PLAT-POWER-VSENSE-001): R24 330 kΩ, VSYS threshold 2.3–2.7 V (schematic, carrier, docs, test)
    With 1 MΩ the NPN turned on near 1.4 V, below the amplifier's 2.5 V minimum.
2026-10-29 feat(PLAT-POWER-MONITOR-001): R2 in line in the harness at the TP4056 B+ pad, R3 on the power-path board
    The sense wire carried raw B+ in 30 AWG behind the polyfuses only; it now carries B+ behind 1 MΩ. P4 loses R2 and its B+ hole (J5–J8 free); boards.py / harness.py learn in-line resistors at the far end of a wire. Schematic regenerated (netlist OK, 51 nets), PDF, board plans, harness guide and wiring SVG updated.
    [tars4.kicad_sch]
2026-10-29 test(TECH-POWER-HOTPLUG-001): bench sheet on the whole robot, second probe at the amplifier VIN (≤ 6.0 V)
2026-10-29 test(PERF-POWER-PATH-001): bench sheet adds the cell charge current on mains (cells in, 10 A socket), bring-up order updated
2026-10-29 feat(PLAT-POWER-DIST-001): C7 part number (Panasonic EEUFC1A471) in the BOM, design notes and shopping list
2026-10-29 feat(PLAT-MECH-CHARGEPORT-001): front post from the floor to the top rail holds the charge-port breakout
    The two 3 mm front tabs only hung on the side wall and the top rail was cantilevered: the plug's push (up to 35 N) is now taken down to the floor, and the rail's front end rests on the post. The post covers the PCB's thickness only, so the wires leave the pads on the component side as before. No new overhang; model clean.
    [tars4.scad]
2026-10-29 tech(TECH-BUILD-CHECKS-001): Orca project meshes refreshed with the charge-port post
    [tars4.3mf, tars4_cr10.3mf]
2026-11-06 req(TECH-HARNESS-BOARDS-001): draft, board layouts for the fewest assembly operations
2026-11-06 req(TECH-HARNESS-BOARDS-001): validated, score weights bridge 1 / cut 1 / jumper 2 / bus 2; pytest local-minimum check (xfail until the optimiser)
2026-11-07 tech(TECH-HARNESS-BOARDS-001): assembly score, link router and layout search in boards.py; keep-outs and wire-end limits checked
2026-11-07 tech(TECH-HARNESS-BOARDS-001): body clearance (diode Ø5.3, glued SOT-23), C1 hand-placed, jumpers labelled J1…
    [boards.py]
2026-11-07 feat(TECH-HARNESS-BOARDS-001): P4 layout 20 → 13 (R1 moved, wires regrouped, 3 jumpers), P3 VSENSE_B on R24's tail; jumper ends ≤ 2 per hole
2026-11-07 tech(TECH-HARNESS-BOARDS-001): SPI names under the screens' SCL / SDA, board-to-board wires listed on each board drawing and checked; layout search also turns parts and swaps strips
    [boards.py, harness.py]
2026-11-07 feat(TECH-HARNESS-BOARDS-001): P2 4 → 3, R17 standing from strip 2 to strip 4 (cut C4 gone), PIR wire at A2
